1708018656-ship-it/-manbo-robot-dog/hardware/kicad/drc-report.txt

Manbo robot dog carrier board V2 rev 2.0 - generated board report (hardware/gen/drc.py, exact geometry)
board: 100 x 90 mm, 2 layers, 38 footprints
nets: 31, routed segments: 271 (1241 mm), vias: 13
clearance: signal 0.20 mm, power 0.30 mm, edge 0.50 mm
track widths: +3V3 0.4 mm, +5V 0.6 mm, +5V_SERVO 1.5 mm, GND 1 mm, VBAT 1.5 mm, VBAT_F 1.5 mm, VBAT_IN 1.5 mm, VBAT_RP 1.5 mm, signal 0.25 mm
unrouted connections: 0
clearance violations: 0
nets not fully connected: 0

Note: the GND pours on both layers are unfilled in the file; press B in
KiCad (Edit > Fill All Zones) before plotting. All GND pads are also
connected by tracks, so the board works without the pour.
