1708018656-ship-it/-manbo-robot-dog/hardware/lite/kicad/pinmap.md

# Manbo robot dog LITE board - Blue Pill pin map

Generated from `hardware/gen/design_lite.py`. Firmware: `make LITE=1` (or add `MANBO_LITE` in Keil). Voice module on USART3.

| Blue Pill pin | STM32 | Net | Goes to |
|---|---|---|---|
| 1 | PB12 | - |  |
| 2 | PB13 | - |  |
| 3 | PB14 | - |  |
| 4 | PB15 | - |  |
| 5 | PA8 | - |  |
| 6 | PA9 | - |  |
| 7 | PA10 | - |  |
| 8 | PA11 | - |  |
| 9 | PA12 | - |  |
| 10 | PA15 | - |  |
| 11 | PB3 | - |  |
| 12 | PB4 | - |  |
| 13 | PB5 | - |  |
| 14 | PB6 | - |  |
| 15 | PB7 | - |  |
| 16 | PB8 | OLED_SCL | J7.3 |
| 17 | PB9 | OLED_SDA | J7.4 |
| 18 | 5V | VLOGIC | (power) |
| 19 | GND | GND | (power) |
| 20 | 3V3 | +3V3 | (power) |
| 21 | GND | GND | (power) |
| 22 | GND | GND | (power) |
| 23 | 3V3 | +3V3 | (power) |
| 24 | NRST | - |  |
| 25 | PB11 | SU_TXD | J6.3 |
| 26 | PB10 | SU_RXD | J6.4 |
| 27 | PB1 | SERVO4_PWM | J5.3 |
| 28 | PB0 | SERVO3_PWM | J4.3 |
| 29 | PA7 | SERVO2_PWM | J3.3 |
| 30 | PA6 | SERVO1_PWM | J2.3 |
| 31 | PA5 | - |  |
| 32 | PA4 | - |  |
| 33 | PA3 | - |  |
| 34 | PA2 | - |  |
| 35 | PA1 | - |  |
| 36 | PA0 | - |  |
| 37 | PC15 | - |  |
| 38 | PC14 | - |  |
| 39 | PC13 | - |  |
| 40 | VBAT | - |  |
