1708018656-ship-it/-manbo-robot-dog/OPTIMIZATION_PLAN.md

# 曼波机器狗整体优化记录（2026-11-01 ～ 11-02，已全部完成）

基线：上游 `RussellCooper-DJZ/manbo-robot-dog` @ `9a3d315`，工作分支 `optimize-2026-11`。

## 状态

**全部完成（11/02）。** 原计划 11/01–11/04 四个时段，提前在 11/02 收尾。

| 检查 | 结果 |
|---|---|
| 主机单元测试（8 组） | 全部通过 |
| ARM GCC 构建（原版接线 / V2 底板） | 通过，0 警告；Flash 约 29.6 KB / 30.3 KB（共 64 KB） |
| Cortex-M3 语法检查、源码编码检查 | 通过 |
| 底板生成器自带 ERC / DRC | 0 违规、0 未连接 |
| **KiCad 8 官方 ERC** | 0 违规 |
| **KiCad 8 官方 DRC**（含原理图一致性） | 0 违规、0 未连接、0 一致性问题 |

以上均在 GitHub Actions 上每次推送自动运行。

## 基线审计结论（11/01）

- 主机单元测试：3 组全部通过（state machine 32 / boundary 100 / format contract）。
- 用 clang `--target=thumbv7m-none-eabi` 对 Keil 工程内全部 C 文件做语法检查（本环境装不了 arm-none-eabi-gcc，无法链接出 .hex）。
- 仓库**没有任何原理图 / PCB 文件**，硬件只有文档描述 → 11/03 从零设计。

### 当前固件引脚表（以代码为准，PCB 将按此设计）

| 功能 | 外设 | 引脚 |
|---|---|---|
| 舵机 ×4 | TIM3 CH1–CH4，50 Hz PWM | PA6, PA7, PB0, PB1 |
| 蓝牙 | USART1 | PA9 (TX), PA10 (RX) |
| SYN6288 语音合成 | USART2 | PA2 (TX), PA3 (RX) |
| ASR 语音识别 | USART3 | PB10 (TX), PB11 (RX) |
| 系统时基 | TIM4 1 ms 中断 | — |
| 板载 LED | GPIO | PC13 |
| OLED（软件 I2C） | GPIO | PB8 (SCL), PB9 (SDA) |
| HC-SR04 超声波 | GPIO + TIM2 计时 | PA0 (Trig), PA1 (Echo) |
| 红外 ×4 | GPIO 输入 | PA4, PA5, PA11, PA12 |

### 11/01 发现的硬件级问题（PCB 设计必须解决）

1. **HC-SR04 Echo 是 5 V 输出，直接接 PA1，而 PA0–PA7 不是 5 V 容忍引脚**，长期使用可能损坏 MCU。→ PCB 上加分压（如 1 kΩ/2 kΩ）或换 3.3 V 版本 RCWL-9610。
2. **红外用了 PA11/PA12 = USB D-/D+**。Blue Pill 板载 PA12 有 1.5 kΩ（常见误焊 10 kΩ）上拉到 3.3 V，会干扰红外读数。→ 新底板把 4 路红外移到 PB12–PB15（5 V 容忍、无冲突），固件同步改。
3. **没有电池电压检测**：所有 ADC 引脚都被占用。红外迁走后释放 PA4 → 电池分压采样，低电量自动趴下+语音提醒。
4. 舵机与逻辑共用电源时，4 个 SG90 同时起动的峰值电流（约 2–3 A）会把 3.3 V 拉低导致复位。→ 舵机电源独立 DC-DC + 大电容。

## 已完成

### 11/01
1. **修复：高级动作语音变成拼音字母朗读**（回归 bug）。非阻塞重构时把中文提示语换成了 `"wo ai ni"` 等拼音，SYN6288 会逐个念英文字母。改为 GBK 字节转义（源码保持 ASCII，任何编辑器打开都不会乱码）。
2. **修复：长语音被截断且可能截断半个汉字**。语音帧缓冲只有 50 字节（正文 ≤44 字节），`mode_biaobai()` 的 55 字节提示语会被砍掉尾部，还可能把一个 GBK 双字节汉字截成一半变成杂音。新增 `System/GbkText.h`，按 SYN6288 手册上限 200 字节并保证不拆汉字；阻塞驱动 `syn6288.c` 和非阻塞 `AudioTask.c` 共用。
3. **修复：`AudioTask` 中 `(uint8_t)strlen()` 溢出**，字符串超过 255 字节时长度会回绕。
4. **修复：`syn6288.c` 包含 `"delay.h"`**，实际文件是 `Delay.h`，在 Linux / CI（大小写敏感）上编译失败。
5. 新增主机测试 `tests/host/test_gbk_text.c`（13 项断言），并修正原测试中锁定拼音行为的断言。

### 11/01（续）
6. **修复：主循环命令分发顺序错误，非阻塞状态机被绕过**。`main.c` 先调 `ActionTask_HandleCommand()` 再读串口，于是新收到的运动命令在同一轮直接掉进旧的阻塞式 `mode_xxx()`（`Delay_ms` 步态），下一轮又被 ActionTask 再执行一次：等于每个动作跑两遍，PoseStep 重构对运动命令完全没生效，急停也要等阻塞动作结束。现在先读串口再分发，ActionTask 优先。
7. 保留原版体验：前进/后退/转弯/摇摆/跳舞会一直重复，直到收到新命令（重构后变成只走一步）。
8. 体力/开心值规则从旧 `mode_xxx()` 迁到 `User/PetStats.h`（数值与 Mode.c 一一对应），新增 20 项主机测试；每个命令对应的 OLED 表情保留。
9. 删除没进工程的死代码：`Hardware/Serial.c/.h`（里面有重复的 `USART1_IRQHandler`，一旦加进工程就链接失败）、空的 `Hardware/Mode.c/.h`（会遮蔽 `User/Mode.h`）。
10. 加 `.gitattributes` / `.editorconfig` 统一换行。
11. **ASRPro 协议对齐**：`CMD_STAND='1'`（STM32 上是抬头）改成 `'q'`，`CMD_SIT='3'`（STM32 不处理）改成 `'s'`，握手改成 `'j'`（交替抬手），补全全部命令常量。新增 `docs/protocol.md` 作为唯一权威协议表。
12. **ASRPro**：`delay(6000)` 阻塞改为 `millis()` 截止时间；非运动命令会取消待发送的停止命令；队列空指针保护；删除手工定义的 `__dso_handle`；`commands.h` 补 `<stdint.h>`（原来先包含它会编译失败）。
13. CI：GitHub Actions 每次推送跑主机测试 + `tools/check_firmware_syntax.sh`（clang 对 Keil 工程全部 27 个 C 文件做 Cortex-M3 语法检查，隐式函数声明直接报错）。
14. 换行符统一单独一个提交（`2b6f8bf`，无代码改动），后面的提交 diff 保持干净。
15. **修复：`Time` 在 `UltrasonicWave.c` 定义为普通变量，`Timer.c` 却声明为 `extern volatile`**：两个编译单元限定符不一致，超声波读数可能被编译器缓存。
16. **修复：体力/开心值在 OLED 上只显示 2 位**（体力 350 会显示成 "50"），统一 3 位。`move()` 加 `speed==0` 保护。
17. 新增 `User/BoardConfig.h`：默认保持原版引脚；定义 `MANBO_BOARD_V2` 后切到新 PCB 引脚（红外迁到 PB12–PB15，PA4 用于电池电压采样）。红外驱动改为用宏。

### 11/02
18. **修复：超声波避障基本测不到近处障碍物**。SensorTask 每 10 ms 才轮询一次 Echo 的上升/下降沿，170 cm 以内的回波（< 10 ms）大多整个错过，测到的也偏短。TIM2 中断本来就只在 Echo 为高时累加 100 µs 计数，现在等一个 30 ms 窗口直接读这个计数。新增主机测试按 0.1 ms 精度模拟中断：旧代码 100 cm / 10 cm 都测不到，新代码测 100 cm 得 101 cm、10 cm 触发右转。
19. **独立看门狗 IWDG**（约 1.6 s，调试暂停时冻结，`-DMANBO_NO_WATCHDOG` 可关）。看门狗复位后跳过开机问候，避免复位循环里一直叫。
20. 主循环里不可达的阻塞分发链删掉，换成只处理 n/K/T/Z 的 switch；新增测试保证协议里每个运动字节都由 ActionTask 接管。
21. **全部源码转 UTF-8**（`tools/fix_encoding.py`）：注释转 UTF-8，GBK 字符串改为 `\x` 转义 + 可读注释。逐个对比转换前后的目标文件，**二进制完全一致**。CI 加编码检查。
22. **电池电压检测**（新板 V2，PA4，100k/33k 分压）：8 点滑动平均，低电 6.8 V 语音提醒，6.4 V 趴下并拒绝动作，带 200 mV 回差；13 项测试。原版接线下自动变成空实现。
23. **舵机校准**：`ServoMath.h` 每个舵机可设 `SERVO_TRIM_DEG` 微调角度（装配后站不平时不用拆舵盘），可选软限位；整数运算，脉宽与原来完全一致；15 项测试。
24. **OLED 非阻塞刷新**：换表情不再同步刷整屏 1 KB，改为标记脏页，UI 任务每 10 ms 发一页。
26. **扩展底板 V2（提前完成）**：`hardware/gen/` 下的 Python 生成器是唯一数据源，输出 KiCad 8 原理图 + PCB、BOM、引脚表、SVG 预览，以及可直接下单的 Gerber/钻孔压缩包（`hardware/fab/`）。100×90 mm 双层，36 个网络全部自动布线（含 GND，22 个过孔），自带精确几何 DRC：0 间距违规、0 未连接；DRC 用故障注入验证过能抓出短路和断线。设计要点见 `hardware/README.md`。
28. **11/02 加时 30 分钟**：README 按现状重写，旧文档加"与当前代码不一致"提示，ASRPro 文档命令码同步。
29. **修复：连续两个命令会丢一个**。主循环原来读串口的"最后一个字节"变量，两个字节来得快（比如 App 连发 `x` 和 `f`）前一个就被覆盖。现在所有字节经环形缓冲进命令队列，蓝牙优先于语音；5 项新测试。
30. **修复：急停后又自己走起来**。安全任务处理急停后把标志清掉了，主循环看不到，持续行走马上恢复。现在标志保留到主循环取走为止。
31. 丝印引脚名缩成 3 个字符，排针上不再挤在一起。

32. **底板精简**：去掉电源指示灯 D1/R11（降压模块自带）、3.3 V 额外电容 C7（Blue Pill 自带）、4 个舵机信号串联电阻 R1–R4，共 7 个元件，电阻规格 7 种 → 5 种。保留开关/防反接（安全）和超声波分压（5 V、3.3 V 两种传感器都能用）。重新布线：31 个网络全通，过孔 22 → 13，DRC 0 违规。
33. 修复布线器的间距规则：信号线靠近电源铜时按两者中较大的间距（0.3 mm）避让，与 DRC 规则一致（之前是碰巧通过）。

34. **KiCad 8 实机校验**：CI 安装 KiCad 8，用 `kicad-cli` 跑 ERC、DRC（含原理图/PCB 一致性）并导出 Gerber 交叉核对。第一次运行发现 4 处元件禁布区（courtyard）重叠，生成器的检查改成与 KiCad 相同的规则后复现了这 4 处，调整布局后 KiCad 报告 0 问题。顺带修了自带 DRC 里一处圆形/矩形判断的潜在 bug。
35. GCC 构建补 `gcc/syscalls.c`，链接不再有 newlib 空实现警告；CI 的 checkout 升到 v5。

36. **精简版（LITE）**：按"只要语音口令 + 运动、尽量便宜"的需求新增。固件 `MANBO_LITE` 编译开关去掉屏幕、语音合成、超声波、红外和体力玩法，增加"10 秒没听到停就自己停"的保护，固件约 12 KB。新底板 70×54 mm、12 个元件：4 节 5 号电池 → SS34 防反接（顺便把新碱性电池的 6.4 V 压到舵机能承受的 6 V）→ 舵机；再经 M7 二极管 + 470 µF 给单片机和 SU-03T 单独供电，舵机启动不会复位。口令配置表见 `docs/su03t.md`。布线 10 个网络全通，0 违规。

37. **精简版加回屏幕和语音回复**：OLED 表情恢复（底板加 J7，从 Blue Pill 3.3 V 供电）；语音回复不用 SYN6288，改由 SU-03T 自带喇叭——识别后它自己回话，开机和自动停下时单片机通过串口发 `AA 55 <编号> 55 AA` 让它播报（`User/Voice.c`，完整版同一接口走 SYN6288）。USART3 增加非阻塞发送。精简版固件约 16.7 KB，底板 13 个网络全通、0 违规。

38. **嘉立创 EDA 导入报错修复**：用户把 PCB 导入嘉立创 EDA 后报 13 个"过孔尺寸"错误（孔 0.4 mm，默认规则要求 ≥0.5 mm）。过孔改为 0.5 mm 孔 / 1.0 mm 焊盘，信号线 0.25 → 0.254 mm（10 mil），丝印线宽 0.12 → 0.15 mm，全部落在嘉立创默认规则内；两块板重新布线，0 违规。顺带修正：自带 DRC 原来写死了旧过孔尺寸，现在直接用板上的实际值。

27. 复查时修正：保险丝从 1812（4 A 规格不存在、电压只有 6–8 V）改为 2920 3 A / ≥16 V。

25. 删除死代码：21 个不可达的 `mode_xxx()`、整个 `Movement.c`（步态已全部在 ActionTask 里）、超声波旧包装函数。代码段（不含 libc）从约 35 KB 降到约 22.5 KB。

## 没做 / 需要实物验证的

- **实物回归测试**：固件改动都有主机测试和真实 ARM 编译，但没在开发板上跑过；底板没打样。第一次上电请按 `hardware/README.md` 的步骤。
- **ASRPro 子项目在 CI 里编译**：它依赖 ASR PRO 厂商 SDK（`set_state_enter_wakeup` 等函数），仓库里没有，无法在 CI 链接；只做了语法检查。
- 可选：超声波改用 TIM2_CH2 硬件输入捕获（精度 1.7 cm → mm 级）。现在的精度对 15 cm 避障阈值已经足够。
