1708018656-ship-it/-manbo-robot-dog/docs/protocol.md

# 串口命令协议（唯一权威表）

蓝牙（USART1，PA9/PA10）和语音识别模块（USART3，PB10/PB11）都向 STM32 发送**单个 ASCII 字节**，9600 8N1。
STM32 端实现：`User/ActionTask.c` → `ActionTask_HandleCommand()`（动作），`User/main.c`（模式开关和状态播报）。
ASRPro 端常量：`ASRPro_Code/include/commands.h`，**改协议时两边和本表一起改**。

蓝牙优先于语音：同一轮里两个串口都收到数据时，以蓝牙为准。

## 运动（持续执行，直到收到新命令）

| 字节 | 动作 | 体力 | 开心 |
|---|---|---|---|
| `f` | 前进 | −5/步 | 连续第 6 步起 −3/步 |
| `b` | 后退 | −5/步 | 同上 |
| `l` | 左转 | −5/步 | 同上 |
| `r` | 右转 | −5/步 | 同上 |
| `w` | 前后摇摆 | −5 | +5 |
| `z` | 左右摇摆 | −5 | +5 |
| `d` | 跳舞 | −5 | +5 |

## 姿态 / 单次动作

| 字节 | 动作 | 体力 | 开心 |
|---|---|---|---|
| `5` | **急停 / 立正**（最高优先级，任何时候都会打断当前动作） | −1 | |
| `q` | 起身 | −1 | |
| `s` | 坐下擦脸 | +5 | +2 |
| `o` | 打招呼 | −2 | +2 |
| `j` | 交替抬手（语音"握手"映射到这里） | −5 | +2 |
| `y` | 伸懒腰 | +5 | +1 |
| `1` | 抬头 | −5 | |
| `p` | 趴下睡觉 | 恢复到 100 | +15 |
| `2` | 卧下睡觉 | 恢复到 100 | +15 |

## 语音表演

| 字节 | 内容 | 体力 | 开心 |
|---|---|---|---|
| `B` | 表白 | −2 | +5 |
| `Y` | 背元素周期表 | −2 | +2 |
| `X` | 背校训 | −2 | |
| `W` | 为世界之光 | | |
| `U` | 被叫"小呆" | | |
| `n` | 难受 | | |

## 模式开关与状态

| 字节 | 功能 |
|---|---|
| `x` / `c` | 打开 / 关闭超声波避障 |
| `H` / `h` | 打开 / 关闭红外防跌落 |
| `K` | 播报开心值 |
| `T` | 播报体力值 |
| `Z` | 播报开心值和体力值 |

## 规则

- 体力 ≤ 0 时只接受睡觉命令（`p` / `2`）。体力上限 500，开心上限 200。
- 数值规则在 `User/PetStats.h`，有主机单元测试 `tests/host/test_pet_stats.c`。
- 语音合成（USART2 → SYN6288）的文本必须是 **GBK** 编码，单帧最多 200 字节。源码里新增中文提示语请写成 `\x` 转义，参考 `User/ActionTask.c`。
