1708018656-ship-it/-manbo-robot-dog/hardware/采购清单.md

# 采购清单（整机）

板上元件的精确清单（位号、封装）见 [kicad/bom.csv](kicad/bom.csv)，由设计文件自动生成。下面是**整台机器狗**要买的东西，方便一次在淘宝 / 立创下单。数量都是一台的用量。

## 一、电路板和板上元件（V2 底板）

| 物品 | 数量 | 搜索关键词 | 说明 |
|---|---|---|---|
| PCB 打样 | 1（一般最少 5 片） | 嘉立创 / JLCPCB | 上传 `fab/manbo-carrier-gerbers.zip`，2 层、1.6 mm、100×90 mm |
| P-MOS 管 | 2 | AO4407A SOP-8 | Q1 开关、Q2 防反接 |
| 自恢复保险丝 | 1 | SMD2920P300TF 2920 3A | 耐压 ≥16 V |
| 0805 电阻 | 1k ×2、2k ×1、10k ×1、33k 1% ×1、100k 1% ×2 | 0805 电阻 | 建议直接买 0805 电阻样品本 |
| 0805 电容 100nF | 3 | 0805 104 | |
| 电解电容 | 1000µF 10V ×1、220µF 10V ×1、100µF 16V ×1 | 直插电解电容 | 1000µF 选 10×13 mm |
| XH2.54 2P 插座 + 端子线 | 2 套 | XH2.54 2P 直针 | 电池、开关各一 |
| 2.54 排针 | 1 条 40P | 2.54 单排针 | 舵机、模块座按需剪 |
| 2.54 单排母 1×20 | 2 | 2.54 单排母 20P | 插 Blue Pill |
| M3 铜柱 + 螺丝 | 4 套 | M3 尼龙/铜柱 | 固定底板 |

## 二、模块和整机零件

| 物品 | 数量 | 搜索关键词 | 说明 |
|---|---|---|---|
| Blue Pill 核心板 | 1 | STM32F103C8T6 最小系统板 | 尽量选正品芯片 |
| ST-Link V2 | 1 | ST-Link V2 下载器 | 烧录用，已有可不买 |
| 降压模块（舵机） | 1 | Mini560 5V 5A 或 MP1584 | **≥3 A**；可调的上板前先调到 5.0 V |
| 降压模块（逻辑） | 1 | MP1584 / Mini360 | ≥1 A，同样先调到 5.0 V |
| SG90 舵机 | 4（建议多买 1 个备用） | SG90 9g 舵机 | MG90S 金属齿更耐用，引脚兼容 |
| 0.96 寸 OLED | 1 | 0.96 OLED I2C 4 针 SSD1306 | 注意引脚顺序 GND-VCC-SCL-SDA |
| 蓝牙模块 | 1 | HC-05 或 HC-06 | |
| 语音合成 | 1 | SYN6288 模块 带喇叭 | |
| 语音识别 | 1 | ASR PRO 语音模块 | 可选 |
| 超声波 | 1 | HC-SR04（或 HC-SR04P 3.3V 版） | 两种都能用 |
| 红外避障模块 | 4 | FC-51 红外避障 | 用于防跌落 |
| 2S 锂电池 | 1 | 7.4V 2S 锂电池 XH 插头 | 容量 1000–2000 mAh 够用 |
| 2S 充电器 | 1 | 2S 平衡充 | |
| 小开关 | 1 | 船型/拨动开关 | 只走信号电流，任何小开关都行 |
| 杜邦线 | 若干 | 母对母杜邦线 | 接 SYN6288、ASR 等引脚顺序不固定的模块 |
| 机身结构 | 1 套 | 3D 打印 / 亚克力 | 原项目未提供结构文件 |
