1708018656-ship-it/-manbo-robot-dog/hardware/lite/采购清单.md

# 精简版采购清单

价格是淘宝常见价的大概范围，仅供参考，以实际下单为准。

| 物品 | 数量 | 搜索关键词 | 大概价格 | 说明 |
|---|---|---|---|---|
| Blue Pill 核心板 | 1 | STM32F103C8T6 最小系统板 | 10–15 元 | |
| SG90 舵机 | 4 | SG90 9g 舵机 | 16–24 元 | |
| SU-03T 离线语音模块（**带麦克风、喇叭**） | 1 | SU-03T 离线语音模块 带喇叭 | 8–15 元 | 语音识别 + 语音回复都靠它；可让店家按 [指令表](../../docs/su03t.md) 代烧录 |
| 0.96 寸 OLED（I2C，4 针） | 1 | 0.96 OLED I2C SSD1306 | 8–12 元 | 引脚顺序选 GND-VCC-SCL-SDA |
| 4 节 5 号电池盒（带开关、引线） | 1 | 4节5号电池盒 带开关 | 2–3 元 | 引线压 XH2.54 端子，或直接焊在板上 |
| SS34 二极管 | 1 | SS34 SMA | 几毛 | |
| M7（1N4007 贴片）二极管 | 1 | M7 SMA | 几毛 | |
| 1000µF 10V、470µF 10V 电解电容 | 各 1 | 直插电解电容 | 1 元左右 | |
| 0805 100nF 电容 | 1 | 0805 104 | 几毛 | |
| 2.54 排针、1×20 排母 ×2、XH2.54 2P | 若干 | | 2–3 元 | |
| PCB（或洞洞板） | 1 | 嘉立创打样 / 洞洞板 | 0–10 元 | 70×54 mm，打样一般最便宜那档 |
| USB 转 TTL（CH340） | 1 | CH340 USB转TTL | 约 5 元 | 烧 SU-03T 用；店家代烧可不买 |
| ST-Link V2 | 1 | ST-Link V2 | 15–20 元 | 烧 STM32 用，已有可不买 |
| 5 号电池 | 4 | 碱性或镍氢 | 自备 | |

**合计（不含电池、下载器）：大约 50–75 元**。语音回复由 SU-03T 自带喇叭完成，省掉约 50 元的 SYN6288；另外省在蓝牙、传感器和 2S 锂电供电。
