1708018656-ship-it/-manbo-robot-dog/hardware/kicad/manbo-carrier.kicad_pcb

## KiCad design hardware/kicad/manbo-carrier.kicad_pcb (2026-11-03)

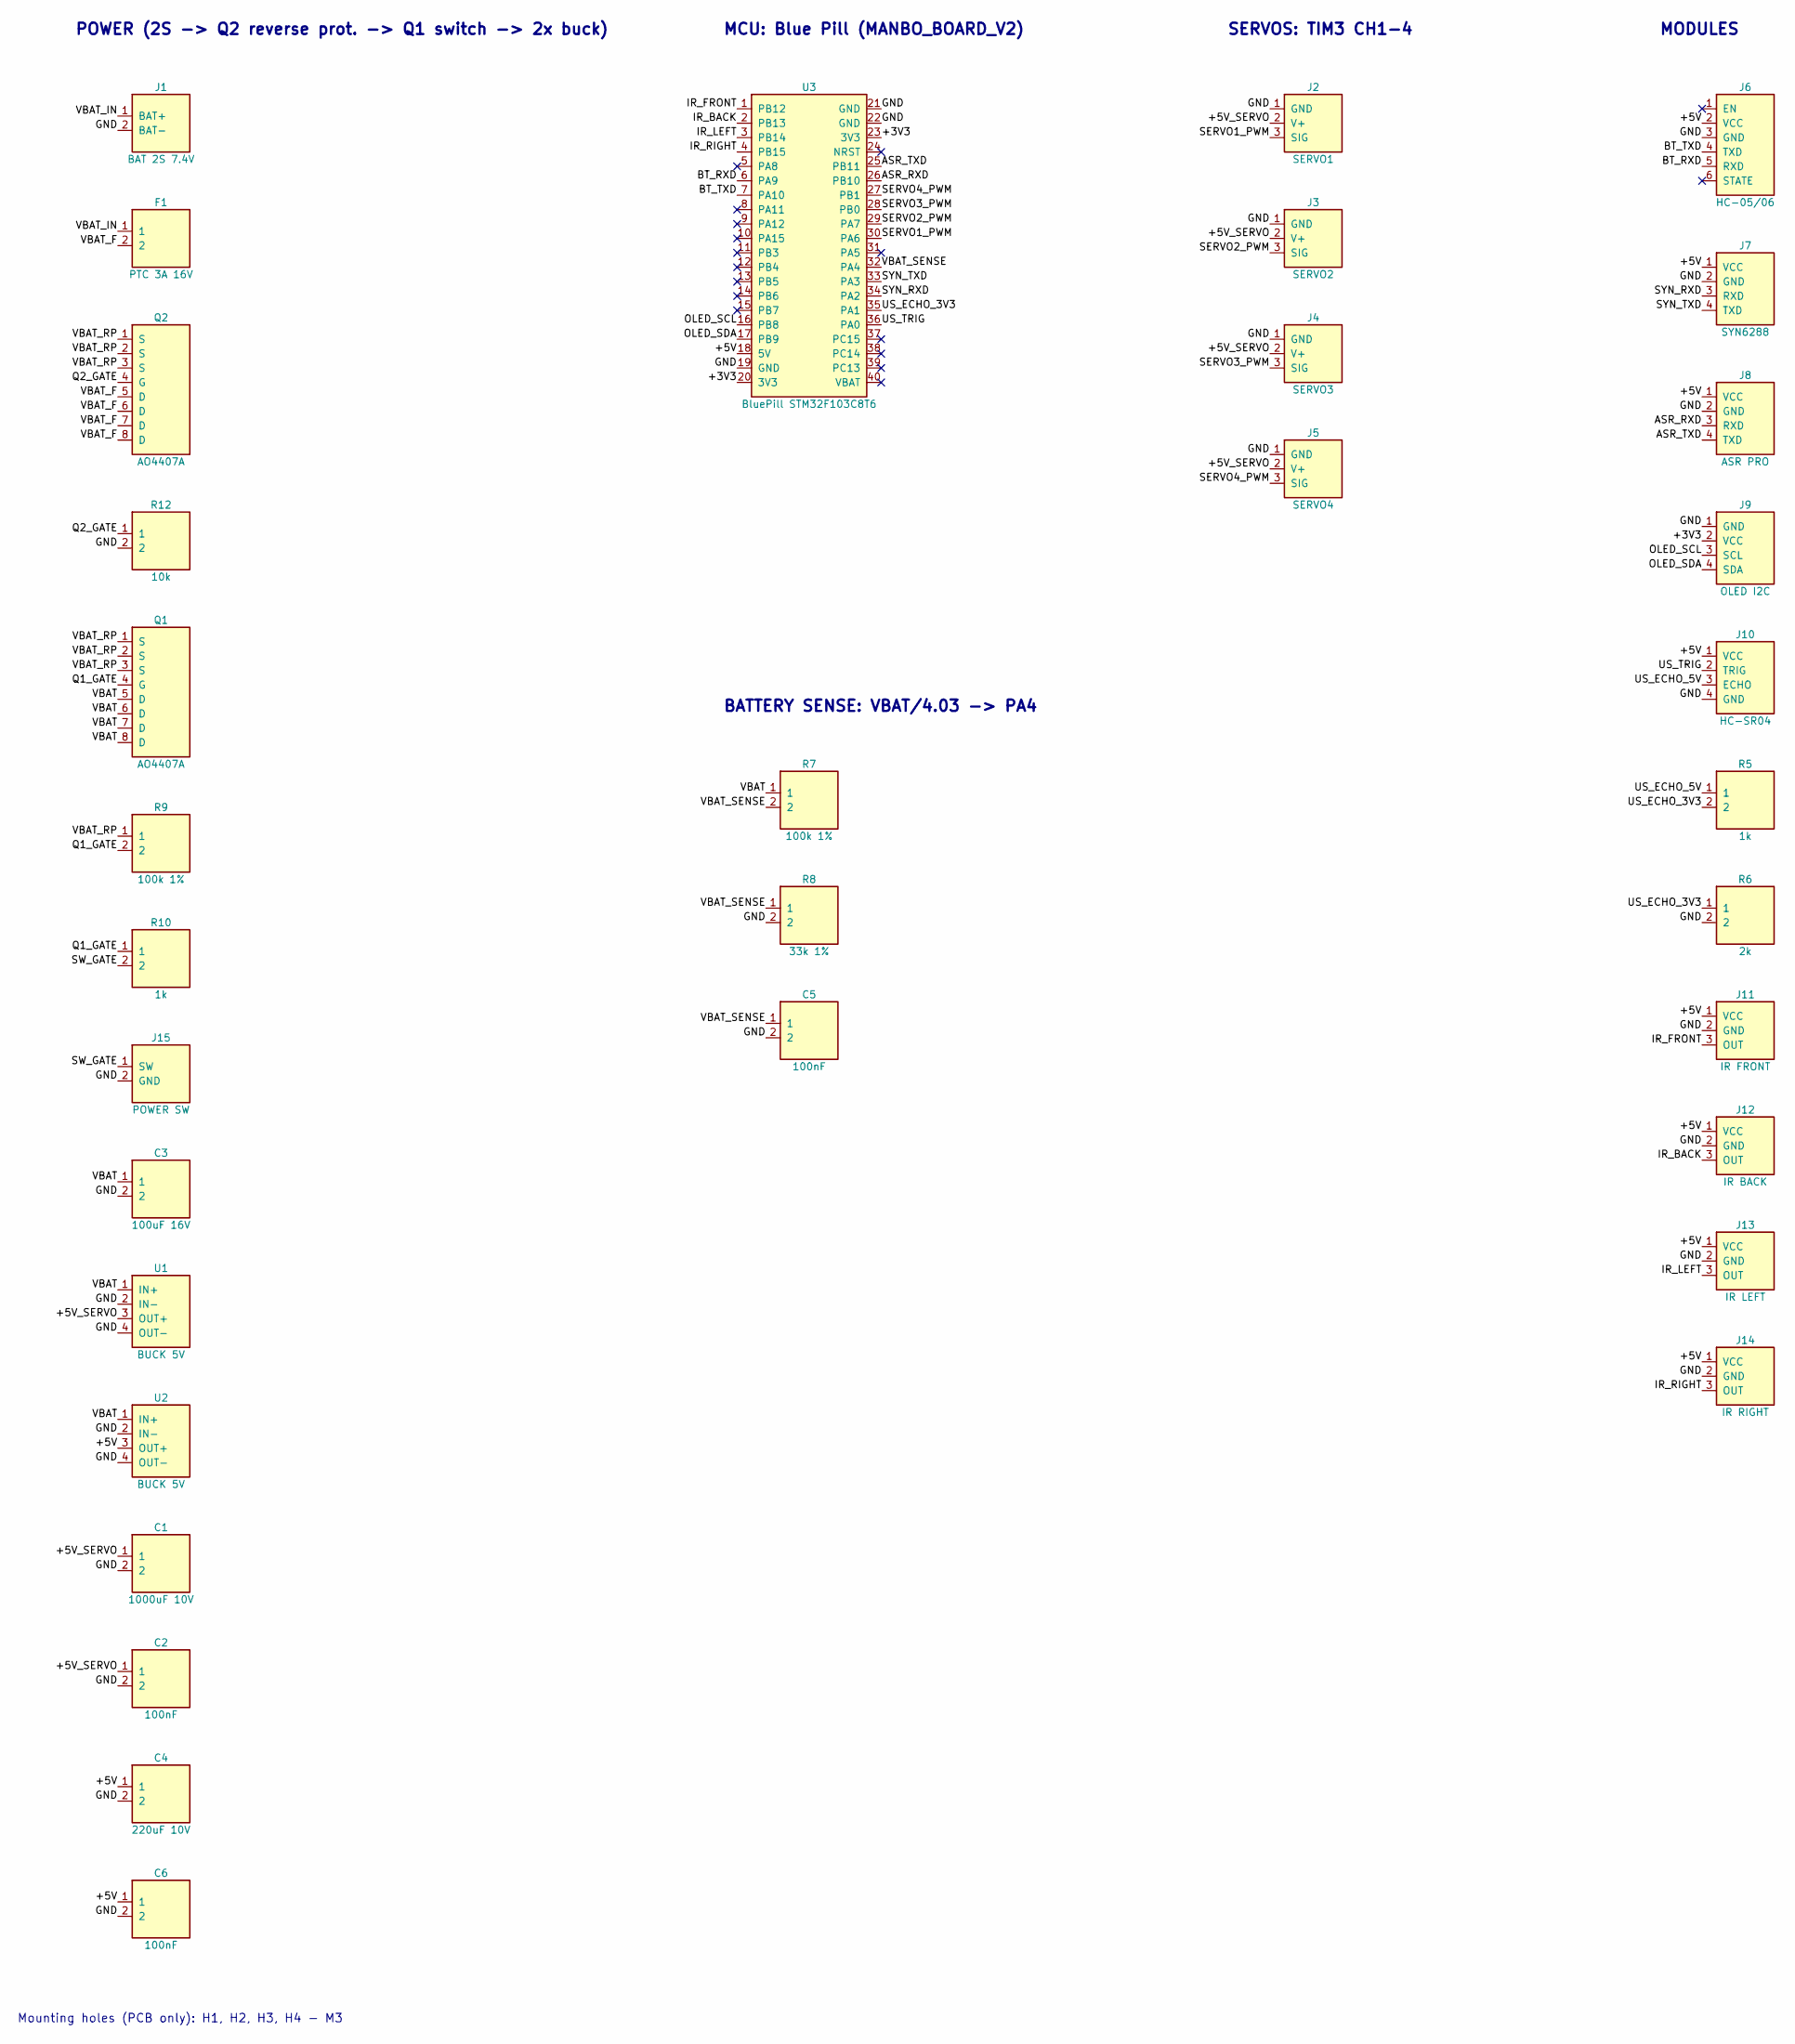
[picture p1: schematic manbo-carrier.kicad_sch, Manbo robot dog carrier board V2]

Parts:
C1: 1000uF 10V; CP_Radial_D10.0mm_P5.00mm; LCSC 1000uF 10V 10x13
C2, C5, C6: 100nF; C_0805_2012Metric; LCSC 0805 100nF
C3: 100uF 16V; CP_Radial_D6.3mm_P2.50mm; LCSC 100uF 16V 6.3x7
C4: 220uF 10V; CP_Radial_D6.3mm_P2.50mm; LCSC 220uF 10V 6.3x7
F1: PTC 3A 16V; Fuse_2920_7451Metric; LCSC SMD2920P300TF/24
J1: BAT 2S 7.4V; JST_XH_B2B-XH-A_1x02_P2.50mm_Vertical; LCSC XH2.54 2P
J2: SERVO1; PinHeader_1x03_P2.54mm_Vertical; LCSC 2.54mm header 3P
J3: SERVO2; PinHeader_1x03_P2.54mm_Vertical; LCSC 2.54mm header 3P
J4: SERVO3; PinHeader_1x03_P2.54mm_Vertical; LCSC 2.54mm header 3P
J5: SERVO4; PinHeader_1x03_P2.54mm_Vertical; LCSC 2.54mm header 3P
J6: HC-05/06; PinHeader_1x06_P2.54mm_Vertical; LCSC 2.54mm header 6P
J7: SYN6288; PinHeader_1x04_P2.54mm_Vertical; LCSC 2.54mm header 4P
J8: ASR PRO; PinHeader_1x04_P2.54mm_Vertical; LCSC 2.54mm header 4P
J9: OLED I2C; PinHeader_1x04_P2.54mm_Vertical; LCSC 2.54mm header 4P
J10: HC-SR04; PinHeader_1x04_P2.54mm_Vertical; LCSC 2.54mm header 4P
J11: IR FRONT; PinHeader_1x03_P2.54mm_Vertical; LCSC 2.54mm header 3P
J12: IR BACK; PinHeader_1x03_P2.54mm_Vertical; LCSC 2.54mm header 3P
J13: IR LEFT; PinHeader_1x03_P2.54mm_Vertical; LCSC 2.54mm header 3P
J14: IR RIGHT; PinHeader_1x03_P2.54mm_Vertical; LCSC 2.54mm header 3P
J15: POWER SW; JST_XH_B2B-XH-A_1x02_P2.50mm_Vertical; LCSC XH2.54 2P
Q1, Q2: AO4407A; SOIC-8_3.9x4.9mm_P1.27mm; LCSC AO4407A
R5, R10: 1k; R_0805_2012Metric; LCSC 0805 1k
R6: 2k; R_0805_2012Metric; LCSC 0805 2k
R7, R9: 100k 1%; R_0805_2012Metric; LCSC 0805 100k 1%
R8: 33k 1%; R_0805_2012Metric; LCSC 0805 33k 1%
R12: 10k; R_0805_2012Metric; LCSC 0805 10k
U1, U2: BUCK 5V; BuckModule_2x2_P2.54mm_17.78mm; LCSC MP1584 / Mini560 module
U3: BluePill STM32F103C8T6; BluePill_Socket_2x20_W15.24mm; LCSC Blue Pill STM32F103C8T6

Connections:
+3V3: J9.2 (VCC), U3.20 (3V3), U3.23 (3V3)
+5V: C4.1, C6.1, J6.2 (VCC), J7.1 (VCC), J8.1 (VCC), J10.1 (VCC), J11.1 (VCC), J12.1 (VCC), J13.1 (VCC), J14.1 (VCC), U2.3 (OUT+), U3.18 (5V)
+5V_SERVO: C1.1, C2.1, J2.2 (V+), J3.2 (V+), J4.2 (V+), J5.2 (V+), U1.3 (OUT+)
ASR_RXD: J8.3 (RXD), U3.26 (PB10)
ASR_TXD: J8.4 (TXD), U3.25 (PB11)
BT_RXD: J6.5 (RXD), U3.6 (PA9)
BT_TXD: J6.4 (TXD), U3.7 (PA10)
GND: C1.2, C2.2, C3.2, C4.2, C5.2, C6.2, J1.2 (BAT-), J2.1 (GND), J3.1 (GND), J4.1 (GND), J5.1 (GND), J6.3 (GND), J7.2 (GND), J8.2 (GND), J9.1 (GND), J10.4 (GND), J11.2 (GND), J12.2 (GND), J13.2 (GND), J14.2 (GND), J15.2 (GND), R6.2, R8.2, R12.2, U1.2 (IN-), U1.4 (OUT-), U2.2 (IN-), U2.4 (OUT-), U3.19 (GND), U3.21 (GND), U3.22 (GND)
IR_BACK: J12.3 (OUT), U3.2 (PB13)
IR_FRONT: J11.3 (OUT), U3.1 (PB12)
IR_LEFT: J13.3 (OUT), U3.3 (PB14)
IR_RIGHT: J14.3 (OUT), U3.4 (PB15)
OLED_SCL: J9.3 (SCL), U3.16 (PB8)
OLED_SDA: J9.4 (SDA), U3.17 (PB9)
Q1_GATE: Q1.4 (G), R9.2, R10.1
Q2_GATE: Q2.4 (G), R12.1
SERVO1_PWM: J2.3 (SIG), U3.30 (PA6)
SERVO2_PWM: J3.3 (SIG), U3.29 (PA7)
SERVO3_PWM: J4.3 (SIG), U3.28 (PB0)
SERVO4_PWM: J5.3 (SIG), U3.27 (PB1)
SW_GATE: J15.1 (SW), R10.2
SYN_RXD: J7.3 (RXD), U3.34 (PA2)
SYN_TXD: J7.4 (TXD), U3.33 (PA3)
US_ECHO_3V3: R5.2, R6.1, U3.35 (PA1)
US_ECHO_5V: J10.3 (ECHO), R5.1
US_TRIG: J10.2 (TRIG), U3.36 (PA0)
VBAT: C3.1, Q1.5 (D), Q1.6 (D), Q1.7 (D), Q1.8 (D), R7.1, U1.1 (IN+), U2.1 (IN+)
VBAT_F: F1.2, Q2.5 (D), Q2.6 (D), Q2.7 (D), Q2.8 (D)
VBAT_IN: F1.1, J1.1 (BAT+)
VBAT_RP: Q1.1 (S), Q1.2 (S), Q1.3 (S), Q2.1 (S), Q2.2 (S), Q2.3 (S), R9.1
VBAT_SENSE: C5.1, R7.2, R8.1, U3.32 (PA4)

Notes on the sheet:
POWER (2S -> Q2 reverse prot. -> Q1 switch -> 2x buck)
MCU: Blue Pill (MANBO_BOARD_V2)
SERVOS: TIM3 CH1-4
MODULES
BATTERY SENSE: VBAT/4.03 -> PA4
Mounting holes (PCB only): H1, H2, H3, H4 - M3

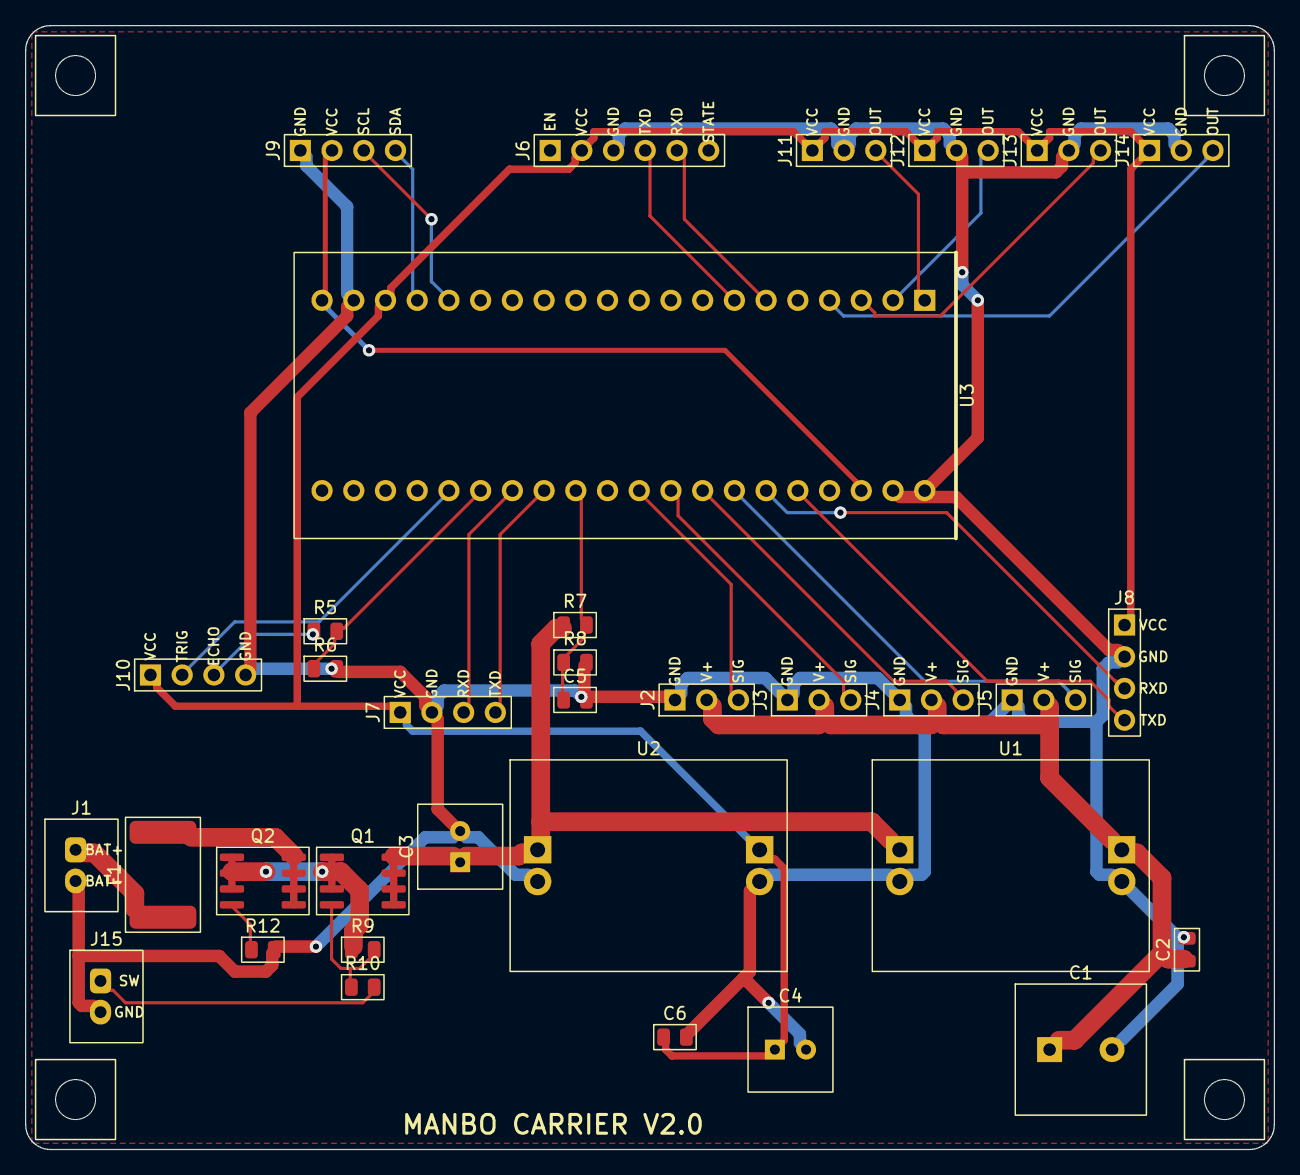
[picture p2: board manbo-carrier.kicad_pcb from above]

Board: 2 copper layers, 100.0 x 90.0 mm, 38 parts (0 on the bottom side), 31 nets.

Other parts of the board:
H1, H2, H3, H4: M3; MountingHole_3.2mm_M3
