1708018656-ship-it/-manbo-robot-dog/hardware/lite/kicad/manbo-lite.kicad_pcb

## KiCad design hardware/lite/kicad/manbo-lite.kicad_pcb (2026-11-03)

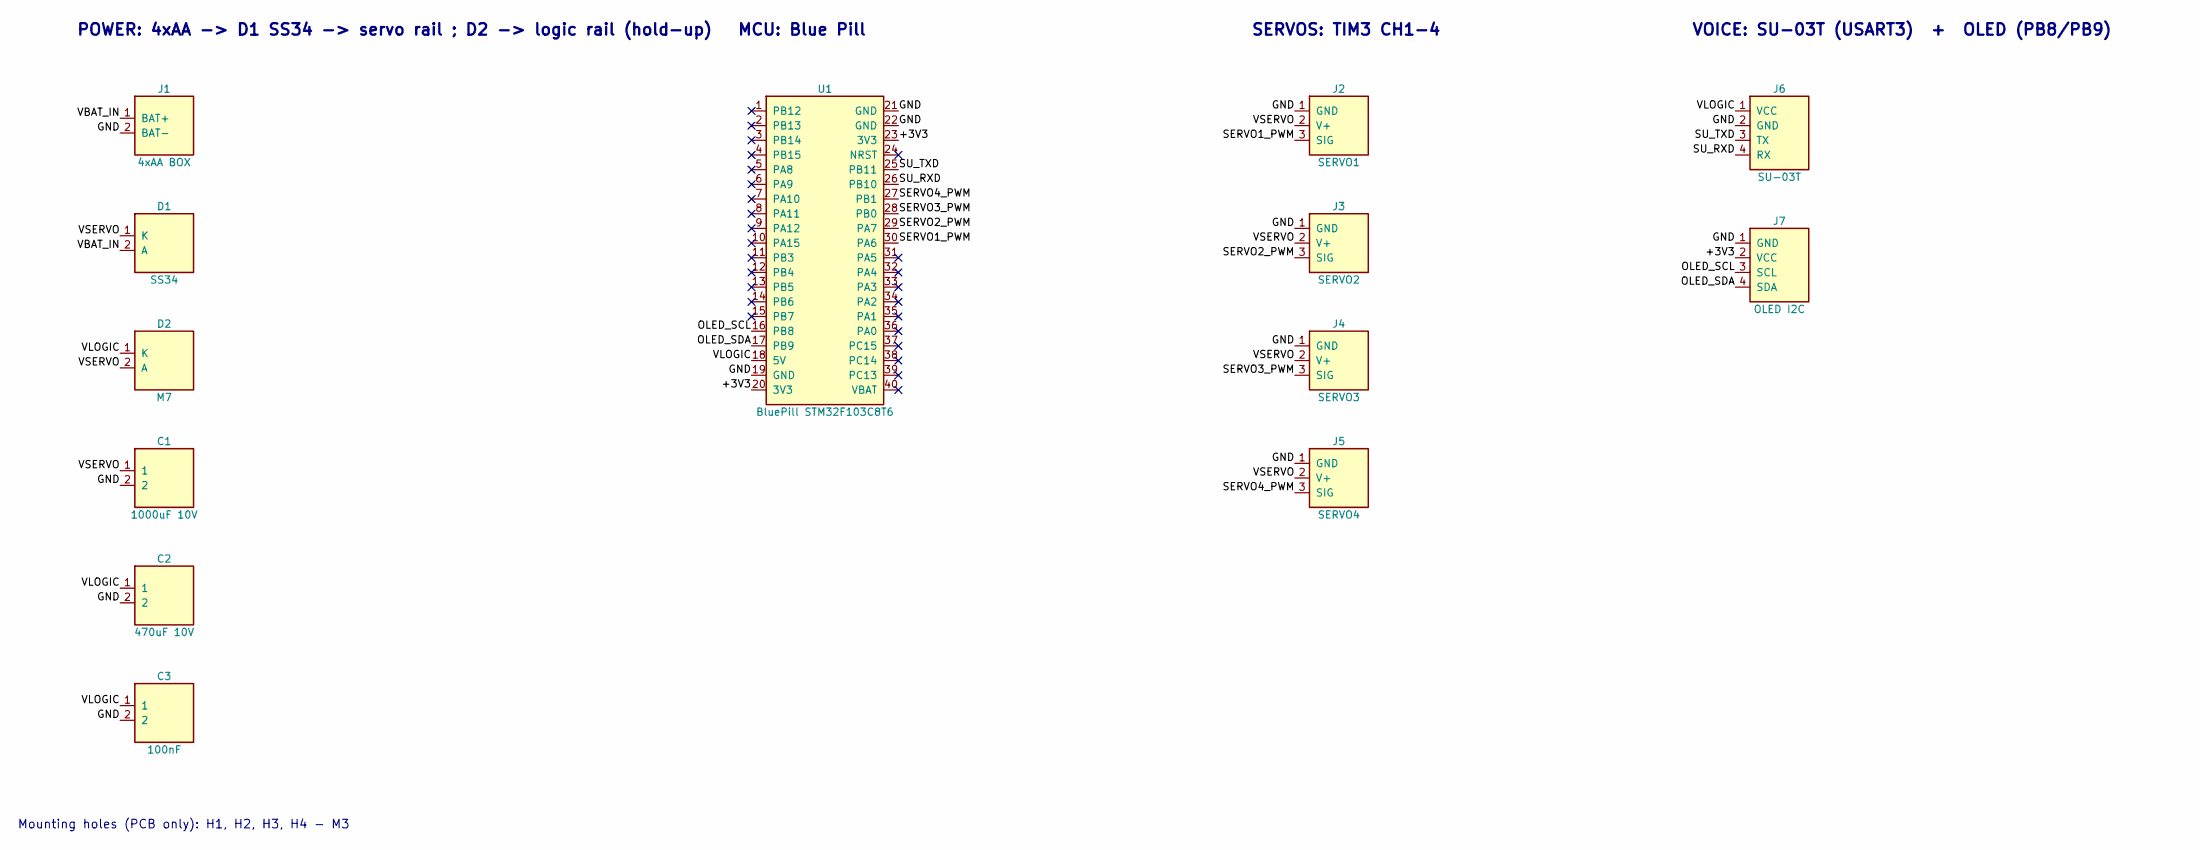
[picture p3: schematic manbo-lite.kicad_sch, Manbo robot dog LITE board]

Parts:
C1: 1000uF 10V; CP_Radial_D10.0mm_P5.00mm; LCSC 1000uF 10V 10x13
C2: 470uF 10V; CP_Radial_D8.0mm_P3.50mm; LCSC 470uF 10V 8x12
C3: 100nF; C_0805_2012Metric; LCSC 0805 100nF
D1: SS34; D_SMA; LCSC SS34 SMA
D2: M7; D_SMA; LCSC M7 1N4007 SMA
J1: 4xAA BOX; JST_XH_B2B-XH-A_1x02_P2.50mm_Vertical; LCSC XH2.54 2P
J2: SERVO1; PinHeader_1x03_P2.54mm_Vertical; LCSC 2.54mm header 3P
J3: SERVO2; PinHeader_1x03_P2.54mm_Vertical; LCSC 2.54mm header 3P
J4: SERVO3; PinHeader_1x03_P2.54mm_Vertical; LCSC 2.54mm header 3P
J5: SERVO4; PinHeader_1x03_P2.54mm_Vertical; LCSC 2.54mm header 3P
J6: SU-03T; PinHeader_1x04_P2.54mm_Vertical; LCSC 2.54mm header 4P
J7: OLED I2C; PinHeader_1x04_P2.54mm_Vertical; LCSC 2.54mm header 4P
U1: BluePill STM32F103C8T6; BluePill_Socket_2x20_W15.24mm; LCSC Blue Pill STM32F103C8T6

Connections:
+3V3: J7.2 (VCC), U1.20 (3V3), U1.23 (3V3)
GND: C1.2, C2.2, C3.2, J1.2 (BAT-), J2.1 (GND), J3.1 (GND), J4.1 (GND), J5.1 (GND), J6.2 (GND), J7.1 (GND), U1.19 (GND), U1.21 (GND), U1.22 (GND)
OLED_SCL: J7.3 (SCL), U1.16 (PB8)
OLED_SDA: J7.4 (SDA), U1.17 (PB9)
SERVO1_PWM: J2.3 (SIG), U1.30 (PA6)
SERVO2_PWM: J3.3 (SIG), U1.29 (PA7)
SERVO3_PWM: J4.3 (SIG), U1.28 (PB0)
SERVO4_PWM: J5.3 (SIG), U1.27 (PB1)
SU_RXD: J6.4 (RX), U1.26 (PB10)
SU_TXD: J6.3 (TX), U1.25 (PB11)
VBAT_IN: D1.2 (A), J1.1 (BAT+)
VLOGIC: C2.1, C3.1, D2.1 (K), J6.1 (VCC), U1.18 (5V)
VSERVO: C1.1, D1.1 (K), D2.2 (A), J2.2 (V+), J3.2 (V+), J4.2 (V+), J5.2 (V+)

Notes on the sheet:
POWER: 4xAA -> D1 SS34 -> servo rail ; D2 -> logic rail (hold-up)
MCU: Blue Pill
SERVOS: TIM3 CH1-4
VOICE: SU-03T (USART3) + OLED (PB8/PB9)
Mounting holes (PCB only): H1, H2, H3, H4 - M3

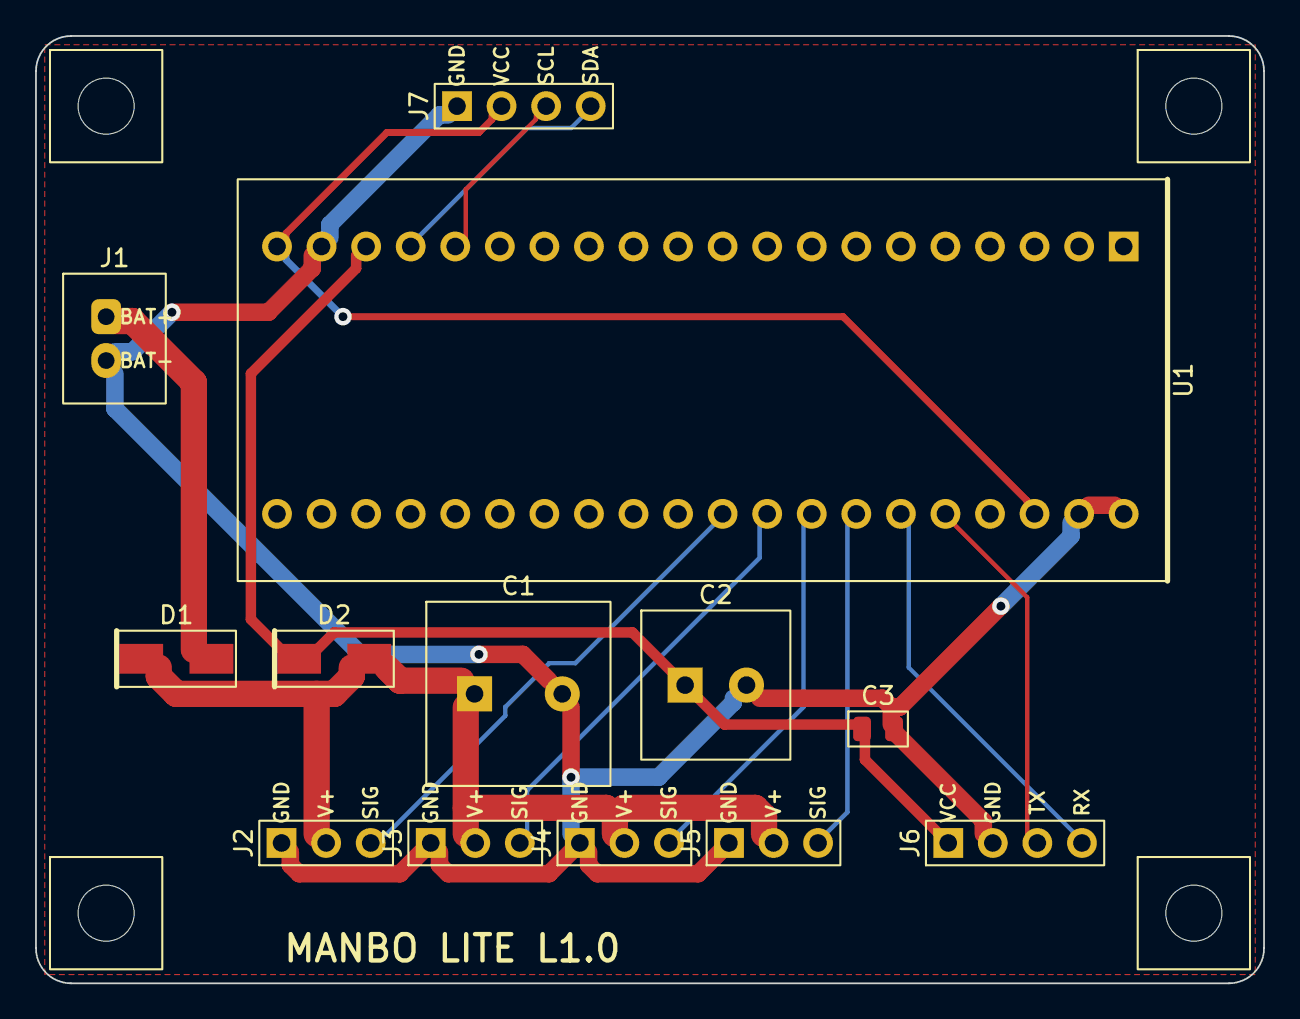
[picture p4: board manbo-lite.kicad_pcb from above]

Board: 2 copper layers, 70.0 x 54.0 mm, 17 parts (0 on the bottom side), 13 nets.

Other parts of the board:
H1, H2, H3, H4: M3; MountingHole_3.2mm_M3
