1708018656-ship-it/-manbo-robot-dog/hardware/gen/design_lite.py

"""
Manbo LITE board - the cheapest build that listens, walks, talks back and shows faces.

Only what is needed for "voice command -> motion":
  4xAA battery box (with its own switch) -> SS34 (reverse protection, also
  trims fresh alkaline 6.4 V to ~6 V for the servos) -> servo rail with a
  1000 uF reservoir; a second diode feeds the logic rail with a 470 uF
  hold-up cap so servo current dips cannot reset the MCU.
  Blue Pill + 4 servo headers + SU-03T offline voice module (UART, speaks
  replies through its own speaker) + 0.96in I2C OLED.

Generated by:  python3 hardware/gen/build.py --variant lite
Firmware:      make LITE=1   (MANBO_LITE; USART3 = SU-03T, 9600 8N1)
"""

from design import Part, two_pin, header, BLUEPILL_LEFT, BLUEPILL_RIGHT, R0805, C0805  # noqa: F401

TITLE = "Manbo robot dog LITE board"
REV = "L1.0"
MCU_REF = "U1"
FIRMWARE_NOTE = "Firmware: `make LITE=1` (or add `MANBO_LITE` in Keil). Voice module on USART3."
SHEET_TITLES = {"power": "POWER: 4xAA -> D1 SS34 -> servo rail ; D2 -> logic rail (hold-up)",
                "mcu": "MCU: Blue Pill", "servo": "SERVOS: TIM3 CH1-4",
                "modules": "VOICE: SU-03T (USART3)  +  OLED (PB8/PB9)"}

PARTS = []
P = PARTS.append

P(Part("J1", "4xAA BOX", "Connector_JST:JST_XH_B2B-XH-A_1x02_P2.50mm_Vertical",
       [("1", "BAT+"), ("2", "BAT-")], {"1": "VBAT_IN", "2": "GND"},
       "4xAA battery box with switch (NiMH 4.8 V or alkaline 6 V)", "XH2.54 2P", group="power"))
# KiCad D_SMA: pad 1 = cathode
P(Part("D1", "SS34", "Diode_SMD:D_SMA", [("1", "K"), ("2", "A")], {"1": "VSERVO", "2": "VBAT_IN"},
       "Schottky 3 A: reverse-polarity protection for the whole board", "SS34 SMA", group="power"))
P(Part("D2", "M7", "Diode_SMD:D_SMA", [("1", "K"), ("2", "A")], {"1": "VLOGIC", "2": "VSERVO"},
       "1N4007 (M7): logic rail isolation, drops ~0.8 V so fresh alkaline stays below 5.5 V",
       "M7 1N4007 SMA", group="power"))
P(two_pin("C1", "1000uF 10V", "Capacitor_THT:CP_Radial_D10.0mm_P5.00mm", "VSERVO", "GND",
          "Servo rail reservoir", "1000uF 10V 10x13", "power"))
P(two_pin("C2", "470uF 10V", "Capacitor_THT:CP_Radial_D8.0mm_P3.50mm", "VLOGIC", "GND",
          "Logic hold-up: keeps MCU + voice module alive through servo dips", "470uF 10V 8x12", "power"))
P(two_pin("C3", "100nF", C0805, "VLOGIC", "GND", "Voice module decoupling", "0805 100nF", "power"))

BP_NETS = {"PA6": "SERVO1_PWM", "PA7": "SERVO2_PWM", "PB0": "SERVO3_PWM", "PB1": "SERVO4_PWM",
           "PB10": "SU_RXD", "PB11": "SU_TXD", "5V": "VLOGIC", "GND": "GND",
           "PB8": "OLED_SCL", "PB9": "OLED_SDA", "3V3": "+3V3"}
bp_pins, bp_nets = [], {}
for i, name in enumerate(BLUEPILL_LEFT + BLUEPILL_RIGHT):
    bp_pins.append((str(i + 1), name))
    if name in BP_NETS:
        bp_nets[str(i + 1)] = BP_NETS[name]
P(Part("U1", "BluePill STM32F103C8T6", "manbo:BluePill_Socket_2x20_W15.24mm", bp_pins, bp_nets,
       "Blue Pill on 2x 1x20 female headers", "Blue Pill STM32F103C8T6", group="mcu"))

for n in range(1, 5):
    P(header("J%d" % (n + 1), "SERVO%d" % n, ["GND", "V+", "SIG"], ["GND", "VSERVO", "SERVO%d_PWM" % n],
             "SG90 servo %d (brown=GND, red=V+, orange=SIG)" % n, group="servo"))

# SU-03T: B7 = UART1 TXD, B6 = UART1 RXD (module datasheet); 3.3 V IO, VCC 3.6-5.5 V
P(header("J6", "SU-03T", ["VCC", "GND", "TX", "RX"], ["VLOGIC", "GND", "SU_TXD", "SU_RXD"],
         "SU-03T voice module: VCC, GND, TX(B7), RX(B6); mic + speaker plug into the module",
         group="modules"))

P(header("J7", "OLED I2C", ["GND", "VCC", "SCL", "SDA"], ["GND", "+3V3", "OLED_SCL", "OLED_SDA"],
         "0.96in SSD1306 I2C OLED, powered from the Blue Pill 3V3 (plugs in directly)", group="modules"))

for i in range(1, 5):
    P(Part("H%d" % i, "M3", "MountingHole:MountingHole_3.2mm_M3", [], {}, "M3 mounting hole", group="mech"))

POWER_NETS = {"GND", "VBAT_IN", "VSERVO", "VLOGIC", "+3V3"}
NET_WIDTH = {"GND": 1.0, "VBAT_IN": 1.5, "VSERVO": 1.5, "VLOGIC": 0.6, "+3V3": 0.4}
DEFAULT_WIDTH = 0.254   # 10 mil: the usual JLC default rule
NETCLASS_PATTERNS = [{"netclass": "Battery", "pattern": "VBAT*"},
                     {"netclass": "Servo", "pattern": "VSERVO"},
                     {"netclass": "Logic5V", "pattern": "VLOGIC"},
                     {"netclass": "GND", "pattern": "GND"}]
FIRMWARE_PINS = {"PA6": "SERVO1_PWM", "PA7": "SERVO2_PWM", "PB0": "SERVO3_PWM", "PB1": "SERVO4_PWM",
                 "PB10": "SU_RXD", "PB11": "SU_TXD", "PB8": "OLED_SCL", "PB9": "OLED_SDA"}


def nets():
    out = {}
    for p in PARTS:
        for num, net in p.nets.items():
            out.setdefault(net, []).append((p.ref, num))
    return out
