1708018656-ship-it/-manbo-robot-dog/System/usart3.c

#include "stm32f10x.h"                  // Device header
#include <stdio.h>
#include <stdarg.h>
#include "Delay.h"
#include "ByteRing.h"
#include <stdlib.h>
//***语音识别***//

uint8_t USART3_RxData;		//定义串口接收的数据变量
uint8_t USART3_RxFlag;		//定义串口接收的标志位变量	
static ByteRing g_USART3_rx_ring;

/* Non-blocking transmit (used by the LITE build to trigger SU-03T phrases). */
#define USART3_TX_CAPACITY 64U
static volatile uint8_t USART3_TxBuffer[USART3_TX_CAPACITY];
static volatile uint8_t USART3_TxHead;
static volatile uint8_t USART3_TxTail;

/**
  * 函    数：串口初始化
  * 参    数：无
  * 返 回 值：无
  */
void USART3_Init(void)
{
	ByteRing_Init(&g_USART3_rx_ring);
	/*开启时钟*/
	RCC_APB1PeriphClockCmd(RCC_APB1Periph_USART3, ENABLE);	//开启USART3的时钟（语音识别）
	RCC_APB2PeriphClockCmd(RCC_APB2Periph_GPIOB, ENABLE);	//开启GPIOB的时钟
	/*GPIO初始化*/
	GPIO_InitTypeDef GPIO_InitStructure;
	GPIO_InitStructure.GPIO_Speed = GPIO_Speed_50MHz;
	GPIO_InitStructure.GPIO_Mode = GPIO_Mode_AF_PP;
	GPIO_InitStructure.GPIO_Pin = GPIO_Pin_10;
	GPIO_Init(GPIOB, &GPIO_InitStructure);					//将PB10引脚初始化为复用推挽输出,PB10是TX
	
	GPIO_InitStructure.GPIO_Mode = GPIO_Mode_IPU;
	GPIO_InitStructure.GPIO_Pin = GPIO_Pin_11;
	GPIO_Init(GPIOB, &GPIO_InitStructure);					//将PB11引脚初始化为输入,PB11是RX
	
	/*USART初始化*/
	USART_InitTypeDef USART_InitStructure;					//定义结构体变量
	USART_InitStructure.USART_BaudRate = 9600;				//波特率
	USART_InitStructure.USART_HardwareFlowControl = USART_HardwareFlowControl_None;	//硬件流控制，不需要
	USART_InitStructure.USART_Mode = USART_Mode_Tx | USART_Mode_Rx;	//模式，发送模式和接收模式均选择
	USART_InitStructure.USART_Parity = USART_Parity_No;		//奇偶校验，不需要
	USART_InitStructure.USART_StopBits = USART_StopBits_1;	//停止位，选择1位
	USART_InitStructure.USART_WordLength = USART_WordLength_8b;		//字长，选择8位
	USART_Init(USART3, &USART_InitStructure);				//将结构体变量交给USART_Init，配置USART3
	
	/*中断输出配置*/
	USART_ITConfig(USART3, USART_IT_RXNE, ENABLE);			//开启串口接收数据的中断
	/*NVIC中断分组*/
	NVIC_PriorityGroupConfig(NVIC_PriorityGroup_2);			//配置NVIC为分组2
	/*NVIC配置*/
	NVIC_InitTypeDef NVIC_InitStructure;					//定义结构体变量
	NVIC_InitStructure.NVIC_IRQChannel = USART3_IRQn;		//选择配置NVIC的USART1线
	NVIC_InitStructure.NVIC_IRQChannelCmd = ENABLE;			//指定NVIC线路使能
	NVIC_InitStructure.NVIC_IRQChannelPreemptionPriority = 1;		//指定NVIC线路的抢占优先级为
	NVIC_InitStructure.NVIC_IRQChannelSubPriority = 3;		//指定NVIC线路的响应优先级为
	NVIC_Init(&NVIC_InitStructure);							//将结构体变量交给NVIC_Init，配置NVIC外设
	
	/*USART使能*/
	USART_Cmd(USART3, ENABLE);								//使能USART3，串口开始运行
}


/**
  * 函    数：获取串口接收标志位
  * 参    数：无
  * 返 回 值：串口接收标志位，范围：0~1，接收到数据后，标志位置1，读取后标志位自动清零
  */
uint8_t USART3_ReadByte(uint8_t *value)
{
	return ByteRing_Pop(&g_USART3_rx_ring, value);
}

uint8_t USART3_RxOverflowed(void)
{
	return ByteRing_HasOverflowed(&g_USART3_rx_ring);
}

uint8_t USART3_GetRxFlag(void)
{
	if (USART3_RxFlag == 1)			//如果标志位为1
	{
		USART3_RxFlag = 0;
		return 1;					//则返回1，并自动清零标志位
	}
	return 0;						//如果标志位为0，则返回0
}

/**
  * 函    数：获取串口接收的数据
  * 参    数：无
  * 返 回 值：接收的数据，范围：0~255
  */
uint8_t USART3_GetRxData(void)
{
	return USART3_RxData;			//返回接收的数据变量
}

/**
  * 函    数：USART2中断函数
  * 参    数：无
  * 返 回 值：无
  * 注意事项：此函数为中断函数，无需调用，中断触发后自动执行
  *           函数名为预留的指定名称，可以从启动文件复制
  *           请确保函数名正确，不能有任何差异，否则中断函数将不能进入
  */

/* Queue up to len bytes; returns how many were accepted (never waits). */
uint8_t USART3_SendBytes(const uint8_t *data, uint8_t len)
{
	uint8_t accepted = 0U;
	uint8_t next_head;

	if (data == 0)
	{
		return 0U;
	}
	while (accepted < len)
	{
		next_head = (uint8_t)((USART3_TxHead + 1U) % USART3_TX_CAPACITY);
		if (next_head == USART3_TxTail)
		{
			break;
		}
		USART3_TxBuffer[USART3_TxHead] = data[accepted];
		USART3_TxHead = next_head;
		accepted++;
	}
	if (accepted != 0U)
	{
		USART_ITConfig(USART3, USART_IT_TXE, ENABLE);
	}
	return accepted;
}

uint8_t USART3_TxFree(void)
{
	return (uint8_t)((USART3_TxTail + USART3_TX_CAPACITY - USART3_TxHead - 1U) % USART3_TX_CAPACITY);
}

void USART3_IRQHandler(void)
{
	if (USART_GetITStatus(USART3, USART_IT_RXNE) == SET)		//判断是否是USART1的接收事件触发的中断
	{
		USART3_RxData = USART_ReceiveData(USART3);				//读取数据寄存器，存放在接收的数据变量
			ByteRing_PushFromIsr(&g_USART3_rx_ring, USART3_RxData);
		USART3_RxFlag = 1;										//置接收标志位变量为1
		USART_ClearITPendingBit(USART3, USART_IT_RXNE);			//清除USART1的RXNE标志位
																//读取数据寄存器会自动清除此标志位
																//如果已经读取了数据寄存器，也可以不执行此代码
	}

	if (USART_GetITStatus(USART3, USART_IT_TXE) == SET)
	{
		if (USART3_TxHead != USART3_TxTail)
		{
			USART_SendData(USART3, USART3_TxBuffer[USART3_TxTail]);
			USART3_TxTail = (uint8_t)((USART3_TxTail + 1U) % USART3_TX_CAPACITY);
		}
		else
		{
			USART_ITConfig(USART3, USART_IT_TXE, DISABLE);
		}
	}
}
