1708018656-ship-it/-manbo-robot-dog/System/usart2.c

#include "stm32f10x.h"                  // Device header
#include <stdio.h>
#include <stdarg.h>
#include "Delay.h"
#include <stdlib.h>
//***语音合成***//

uint8_t USART2_RxData;		//定义串口接收的数据变量
uint8_t USART2_RxFlag;

#define USART2_TX_CAPACITY 256U
static volatile uint8_t USART2_TxBuffer[USART2_TX_CAPACITY];
static volatile uint8_t USART2_TxHead;
static volatile uint8_t USART2_TxTail;
	//定义串口接收的标志位变量

/**
  * 函    数：串口初始化
  * 参    数：无
  * 返 回 值：无
  */
void USART2_Init(void)
{
	/*开启时钟*/
	RCC_APB2PeriphClockCmd(RCC_APB2Periph_GPIOA, ENABLE);	//开启GPIOA的时钟
	RCC_APB1PeriphClockCmd(RCC_APB1Periph_USART2, ENABLE);	//开启USART2的时钟（语音合成）
	/*GPIO初始化*/
	GPIO_InitTypeDef GPIO_InitStructure;
	GPIO_InitStructure.GPIO_Speed = GPIO_Speed_50MHz;
	GPIO_InitStructure.GPIO_Mode = GPIO_Mode_AF_PP;
	GPIO_InitStructure.GPIO_Pin = GPIO_Pin_2;
	GPIO_Init(GPIOA, &GPIO_InitStructure);					//将PA2引脚初始化为复用推挽输出,PA2是TX

	GPIO_InitStructure.GPIO_Mode = GPIO_Mode_IPU;
	GPIO_InitStructure.GPIO_Pin = GPIO_Pin_3;
	GPIO_Init(GPIOA, &GPIO_InitStructure);					//将PA3引脚初始化为输入,PA3是RX

	/*USART初始化*/
	USART_InitTypeDef USART_InitStructure;					//定义结构体变量
	USART_InitStructure.USART_BaudRate = 9600;				//波特率
	USART_InitStructure.USART_HardwareFlowControl = USART_HardwareFlowControl_None;	//硬件流控制，不需要
	USART_InitStructure.USART_Mode = USART_Mode_Tx | USART_Mode_Rx;	//模式，发送模式和接收模式均选择
	USART_InitStructure.USART_Parity = USART_Parity_No;		//奇偶校验，不需要
	USART_InitStructure.USART_StopBits = USART_StopBits_1;	//停止位，选择1位
	USART_InitStructure.USART_WordLength = USART_WordLength_8b;		//字长，选择8位
	USART_Init(USART2, &USART_InitStructure);				//将结构体变量交给USART_Init，配置USART2

	/*中断输出配置*/
	USART_ITConfig(USART2, USART_IT_RXNE, ENABLE);			//开启串口接收数据的中断
	/*NVIC中断分组*/
	NVIC_PriorityGroupConfig(NVIC_PriorityGroup_2);			//配置NVIC为分组2
	/*NVIC配置*/
	NVIC_InitTypeDef NVIC_InitStructure;					//定义结构体变量
	NVIC_InitStructure.NVIC_IRQChannel = USART2_IRQn;		//选择配置NVIC的USART1线
	NVIC_InitStructure.NVIC_IRQChannelCmd = ENABLE;			//指定NVIC线路使能
	NVIC_InitStructure.NVIC_IRQChannelPreemptionPriority = 1;		//指定NVIC线路的抢占优先级为
	NVIC_InitStructure.NVIC_IRQChannelSubPriority = 2;		//指定NVIC线路的响应优先级为
	NVIC_Init(&NVIC_InitStructure);							//将结构体变量交给NVIC_Init，配置NVIC外设

	/*USART使能*/
	USART_Cmd(USART2, ENABLE);								//使能USART2，串口开始运行
}


/**
  * 函    数：串口发送一个字符串
  * 参    数：String 要发送字符串的首地址,长度
  * 返 回 值：无
  */
uint8_t USART2_SendString(u8 *DAT, u8 len)
{
	u8 accepted = 0U;
	uint8_t next_head;

	if (DAT == 0)
	{
		return 0U;
	}

	while (accepted < len)
	{
		next_head = (uint8_t)(USART2_TxHead + 1U);
		if (next_head == USART2_TxTail)
		{
			break; /* bounded enqueue: never wait for TXE */
		}
		USART2_TxBuffer[USART2_TxHead] = DAT[accepted];
		USART2_TxHead = next_head;
		accepted++;
	}

	if (accepted != 0U)
	{
		USART_ITConfig(USART2, USART_IT_TXE, ENABLE);
	}
	return accepted;
}

/**
  * 函    数：获取串口接收标志位
  * 参    数：无
  * 返 回 值：串口接收标志位，范围：0~1，接收到数据后，标志位置1，读取后标志位自动清零
  */
uint8_t USART2_GetRxFlag(void)
{
	if (USART2_RxFlag == 1)			//如果标志位为1
	{
		USART2_RxFlag = 0;
		return 1;					//则返回1，并自动清零标志位
	}
	return 0;						//如果标志位为0，则返回0
}

/**
  * 函    数：获取串口接收的数据
  * 参    数：无
  * 返 回 值：接收的数据，范围：0~255
  */
uint8_t USART2_GetRxData(void)
{
	return USART2_RxData;			//返回接收的数据变量
}

/**
  * 函    数：USART2中断函数
  * 参    数：无
  * 返 回 值：无
  * 注意事项：此函数为中断函数，无需调用，中断触发后自动执行
  *           函数名为预留的指定名称，可以从启动文件复制
  *           请确保函数名正确，不能有任何差异，否则中断函数将不能进入
  */

void USART2_IRQHandler(void)
{
	if (USART_GetITStatus(USART2, USART_IT_RXNE) == SET)
	{
		USART2_RxData = USART_ReceiveData(USART2);
		USART2_RxFlag = 1;
		USART_ClearITPendingBit(USART2, USART_IT_RXNE);
	}

	if (USART_GetITStatus(USART2, USART_IT_TXE) == SET)
	{
		if (USART2_TxHead != USART2_TxTail)
		{
			USART_SendData(USART2, USART2_TxBuffer[USART2_TxTail]);
			USART2_TxTail++;
		}
		else
		{
			USART_ITConfig(USART2, USART_IT_TXE, DISABLE);
		}
	}
}
