1708018656-ship-it/-manbo-robot-dog/User/SafetyTask.c

#include "SafetyTask.h"
#include "ActionTask.h"

#define SAFETY_FAULT_COMM_OVERFLOW 0x01U

static volatile uint8_t g_stop_request = 0U;
static volatile uint8_t g_fault_flags = 0U;

void SafetyTask_Init(void)
{
    g_stop_request = 0U;
    g_fault_flags = 0U;
}

void SafetyTask_RequestEmergencyStop(void)
{
    g_stop_request = 1U;
}

void SafetyTask_RequestCommunicationFault(void)
{
    g_fault_flags |= SAFETY_FAULT_COMM_OVERFLOW;
    g_stop_request = 1U;
}

void SafetyTask_Run(uint32_t now_ms)
{
    (void)now_ms;

    if (g_stop_request != 0U)
    {
        /* Stop the motion now, but leave the request set: main() must also
         * see it (SafetyTask_ConsumeStopRequest) to cancel continuous walking,
         * otherwise the dog would start walking again right after the stop. */
        ActionTask_AbortToSafeStop();
    }
}

uint8_t SafetyTask_ConsumeStopRequest(void)
{
    uint8_t requested;

    requested = g_stop_request;
    g_stop_request = 0U;
    return requested;
}

uint8_t SafetyTask_IsFaultActive(void)
{
    return (g_fault_flags != 0U) ? 1U : 0U;
}
