1708018656-ship-it/-manbo-robot-dog/Hardware/UltrasonicWave.c

#include "stm32f10x.h"                  // Device header
/* HC-SR04 GPIO setup. Ranging itself is done by User/SensorTask.c. */

volatile uint16_t Time; /* written in TIM2 ISR; must match extern in Timer.c */ //记录时间
void UltrasonicWave_Init(void)
{
	RCC_APB2PeriphClockCmd(RCC_APB2Periph_GPIOA, ENABLE);	//开启GPIOA的时钟
	/*GPIO初始化*/ 
	GPIO_InitTypeDef GPIO_InitStructure;
	

	GPIO_InitStructure.GPIO_Mode = GPIO_Mode_Out_PP;
	GPIO_InitStructure.GPIO_Pin = GPIO_Pin_0;
	GPIO_InitStructure.GPIO_Speed = GPIO_Speed_50MHz;
	GPIO_Init(GPIOA, &GPIO_InitStructure);					//将PA0 TRIG
	
	GPIO_InitStructure.GPIO_Mode = GPIO_Mode_IPD;
	GPIO_InitStructure.GPIO_Pin = GPIO_Pin_1;
	GPIO_InitStructure.GPIO_Speed = GPIO_Speed_50MHz;
	GPIO_Init(GPIOA, &GPIO_InitStructure);					//将PA1 ECHO

	GPIO_ResetBits(GPIOA, GPIO_Pin_0);
	
	
}
