1708018656-ship-it/-manbo-robot-dog/User/Mode.h

#ifndef __MODE_H
#define __MODE_H
void mode_nanshou(void);//难受
void OLED_happiness(void);//OLED展示开心值
void mode_happiness(void);//展示开心值
void OLED_stamina(void);//OLED展示开心值
void mode_stamina(void);//展示体力值
void mode_index(void);//展示开心值和体力值
#endif
