1708018656-ship-it/-manbo-robot-dog/Hardware/Timer.c

#include "stm32f10x.h"                  // Device header
//为超声避障服务
extern volatile uint16_t Time;
void Timer_Init(void)
{
	Time = 0;
	RCC_APB1PeriphClockCmd(RCC_APB1Periph_TIM2, ENABLE);	//选择APB1总线下的定时器Timer2
	
	TIM_InternalClockConfig(TIM2);		//TIM2使用内部时钟
	
	TIM_TimeBaseInitTypeDef TIM_TimeBaseInitStructure;
	TIM_TimeBaseInitStructure.TIM_ClockDivision = TIM_CKD_DIV1;
	TIM_TimeBaseInitStructure.TIM_CounterMode = TIM_CounterMode_Up;		//计数模式，此处为向上计数
	TIM_TimeBaseInitStructure.TIM_Period = 7200-1;		//ARR 1 = 0.0001S
	TIM_TimeBaseInitStructure.TIM_Prescaler = 0;		//PSC
	TIM_TimeBaseInitStructure.TIM_RepetitionCounter = 0;		//高级计时器特有，重复计数
	TIM_TimeBaseInit(TIM2, &TIM_TimeBaseInitStructure);
	
	TIM_ClearFlag(TIM2, TIM_FLAG_Update);
	TIM_ITConfig(TIM2, TIM_IT_Update, ENABLE);		//使能中断
	
	NVIC_PriorityGroupConfig(NVIC_PriorityGroup_2);
	
	NVIC_InitTypeDef NVIC_InitStructure;
	NVIC_InitStructure.NVIC_IRQChannel = TIM2_IRQn;		//中断通道选择
	NVIC_InitStructure.NVIC_IRQChannelCmd = ENABLE;
	NVIC_InitStructure.NVIC_IRQChannelPreemptionPriority = 2;
	NVIC_InitStructure.NVIC_IRQChannelSubPriority = 1;		//优先级，同上
	
	NVIC_Init(&NVIC_InitStructure);
	
		TIM_Cmd(TIM2, ENABLE);		//打开定时器

}

void Timer_Stop(void)
{
	TIM_Cmd(TIM2, DISABLE);
	TIM_ITConfig(TIM2, TIM_IT_Update, DISABLE);
}

void TIM2_IRQHandler()		//定时器2的中断函数，不懂直接套用
{
	if(TIM_GetITStatus(TIM2, TIM_IT_Update) == SET)
	{

		if (GPIO_ReadInputDataBit(GPIOA, GPIO_Pin_1) == 1)
		{
			Time ++;
		}
		TIM_ClearITPendingBit(TIM2, TIM_IT_Update);		//清空标志位
	}
}
