1708018656-ship-it/-manbo-robot-dog/(commit log)

2026-08-14 优化舵机边界保护和串口指令判断
2026-08-14 修复三个高优先级内存与入口问题
2026-08-14 完善项目 README 文档
2026-08-14 新增非阻塞状态机重构方案
2026-08-14 实现协作式任务调度骨架
2026-08-14 接入通信任务与安全急停
2026-08-14 迁移基础动作到 PoseStep 状态机
2026-08-14 迁移复杂表演动作到 PoseStep
2026-08-14 迁移高级模式与非阻塞语音
2026-08-15 增加状态机主机单元测试
2026-08-15 增加串口和定时器边界测试
2026-08-15 修复格式化函数栈溢出风险
2026-08-15 refactor: complete non-blocking sensor and audio tasks
2026-08-19 Add on-target scheduler performance probes
2026-08-19 Gate performance probes out of production builds
2026-11-01 fix(audio): restore Chinese speech, GBK-safe 200-byte SYN6288 frames
    - Advanced actions spoke pinyin letters ("wo ai ni") after the
    non-blocking refactor; use GBK byte escapes so SYN6288 speaks Chinese
    and the source stays ASCII-clean.
    - Raise speech frame capacity from 44 to the SYN6288 limit of 200 bytes
    and never split a double-byte GBK character when truncating
    (new System/GbkText.h shared by syn6288.c and AudioTask.c).
    - Fix uint8_t overflow of strlen() in AudioTask.
    - Fix "delay.h" include case so the driver builds on case-sensitive FS.
    - Add host tests for GBK truncation; add OPTIMIZATION_PLAN.md.
    Claude-Session: https:/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
    [ActionTask.c, AudioTask.c, GbkText.h, syn6288.c, test_gbk_text.c, test_state_machine.c]
2026-11-01 docs(plan): record pin map and hardware-level issues for PCB redesign
    Claude-Session: https://claude.ai/code/session_011zCL3ZwaaXuHdfsgiLwp1L
2026-11-01 fix(main): route new commands to non-blocking ActionTask first
    The serial byte was read *after* ActionTask_HandleCommand(), so every new
    motion command fell into the blocking legacy mode_xxx() chain in the same
    loop iteration (Delay_ms-based gait), and was then executed a second time
    by ActionTask on the next iteration. The PoseStep refactor was effectively
    bypassed for motion commands.
    - Read USART1/USART3 before dispatch; ActionTask gets first refusal.
    - Keep legacy UX: walking/swing/dance repeat until a new command.
    - Move stamina/happiness rules into header-only User/PetStats.h
    (values copied 1:1 from Mode.c) with host tests, and keep the
    per-command OLED faces.
    - Remove dead files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
    [Mode.c, PetStats.h, main.c, test_pet_stats.c]
2026-11-01 fix(asr): align command codes with STM32, non-blocking stop
    - CMD_STAND '1'->'q', CMD_SIT '3'->'s', shake hand -> 'j'; add all
    remaining command constants. '1' is head-up on STM32 and '3' was
    never handled.
    - Replace delay(6000) with a millis() deadline serviced in ASR_Process();
    non-motion commands cancel a pending stop.
    - Guard queue use before ASR_Init(); drop hand-defined __dso_handle.
    - commands.h now includes <stdint.h> (failed when included first).
    - docs/protocol.md: single authoritative command table.
    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
    [asr.cpp, commands.h]
2026-11-01 fix: volatile mismatch on Time, 3-digit stat display, speed guard
    - UltrasonicWave.c defined `uint16_t Time` while Timer.c declared it
    `extern volatile`; the ISR-written counter could be cached. Define it
    volatile.
    - Stamina goes up to 500 and happiness to 200, but OLED_ShowNum used
    2 digits unless the value was exactly 100 (350 displayed as "50").
    - move(): guard speed==0 before 1000/speed.
    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
    [Mode.c, UltrasonicWave.c]
2026-11-01 feat(board): BoardConfig.h with MANBO_BOARD_V2 pin map
    Default keeps the original wiring. MANBO_BOARD_V2 (new carrier PCB)
    moves the four IR sensors from PA4/PA5/PA11/PA12 to 5V-tolerant
    PB12..PB15 (PA11/PA12 are USB D-/D+ and Blue Pill pulls PA12 up),
    freeing PA4 for battery-voltage sensing.
    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
2026-11-01 fix(ir): non-blocking cliff avoidance through ActionTask
    Edge_detect() ran blocking move_behind()/move_forward() sequences, so
    emergency stop and all tasks froze while avoiding a cliff. It now submits
    a pre-emptive avoidance action to ActionTask and returns 1 so main()
    cancels continuous walking (no walking back into the edge).
    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
    [Hongwai.c, Hongwai.h, main.c]
2026-11-01 build: GCC Makefile, linker script and C startup; CI ARM build
    - Makefile reuses the C file list from Project.uvprojx; Keil startup .s
    is ARMCC-only so gcc/startup_stm32f103xb.c provides the same vector
    table. `make V2=1` selects the new carrier PCB pin map.
    - gcc/STM32F103C8Tx.ld: 64K flash / 20K RAM, stack/heap as in Keil.
    - Fix old CMSIS core_cm3.c strex{,b,h} asm constraints ("=&r"); modern
    GCC rejects them with "registers may not be the same".
    - CI: build both board variants with arm-none-eabi-gcc, upload .hex/.bin.
    Test-linked locally with clang+lld: only newlib/libgcc symbols missing,
    .text ~35 KB of 64 KB.
    Claude-Session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
    [startup_stm32f103xb.c]
2026-11-01 fix(mode): non-blocking K/T/Z status reports
    mode_happiness/mode_stamina/mode_index blocked the main loop for up to
    10 s (Delay_s plus blocking shake/sleep moves), during which even the
    emergency stop was ignored. They now queue one combined GBK utterance via
    AudioTask and the follow-up pose via ActionTask. This also stops the
    blocking SYN_FrameInfo() and AudioTask from writing USART2 concurrently.
    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
    [Mode.c]
2026-11-01 fix(main): no command replay at zero stamina; non-blocking nanshou
    At stamina 0 the loop peeked USART RxData without consuming the flag and
    ran the blocking sleep routine; once stamina was restored the same byte
    was consumed again as a fresh command (sleep twice, +30 happiness).
    Bytes are now always consumed; at stamina <= 0 only '2'/'p' pass, and
    they go through ActionTask like everything else.
    mode_nanshou/mode_xiaodai no longer block (AudioTask + ActionTask).
    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
    [Mode.c, main.c]
2026-11-02 feat: independent watchdog; drop unreachable blocking dispatch
    - All motion bytes are owned by ActionTask, so the legacy if-chain of
    blocking mode_xxx() calls in main.c was dead code. Replace it with a
    small switch for the few non-motion commands (n/K/T/Z, mode switches).
    - New host test: every motion byte in docs/protocol.md is accepted by
    ActionTask and non-motion bytes are not (guards against silently
    falling back to blocking code).
    - Enable IWDG (~1.6 s, frozen while debugging; -DMANBO_NO_WATCHDOG to
    disable), fed once per loop. Safe now that the loop has no multi-second
    delays.
    Claude-Session: https://claude.ai/code/se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
    [Watchdog.h, main.c, test_state_machine.c]
2026-11-02 chore: convert all firmware sources to UTF-8 (byte-identical binaries)
    Sources mixed GBK, UTF-8 and both inside one file (main.c), so Keil and
    GitHub showed half of the comments as mojibake. tools/fix_encoding.py
    converts comments to UTF-8 and rewrites every non-ASCII string literal as
    \x escapes of its original bytes (GBK for SYN6288 speech and OLED font
    keys) plus a readable comment.
    Verified: every User/System/Hardware object file compiled before and
    after conversion is byte-identical (llvm-objdump -s). Three comments
    whose GBK bytes happened to be valid UTF-8 were fixed by hand.
    CI now rejects non-UTF-8 sources and raw non-ASCII literals.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
    [Mode.c, Mode.h, OLED.c, OLED.h, OLED_Data.c, OLED_Data.h, Timer.c, UltrasonicWave.c]
2026-11-02 feat(battery): 2S battery monitor for board V2 (PA4 / ADC1_IN4)
    - User/Battery.h: integer mV conversion for a 100k/33k divider, 8-sample
    moving average, LOW 6.8 V / CRITICAL 6.4 V with 200 mV hysteresis,
    "no battery" detection for USB-powered bench work. 13 host tests.
    - User/BatteryTask.c: non-blocking ADC sampling at 10 Hz from the sensor
    slot; compiles to a stub on the original wiring (always UNKNOWN).
    - main.c: LOW -> spoken charge reminder; CRITICAL -> stop walking, lie
    down, refuse motion (sleep and emergency stop still accepted).
    - Added to Project.uvprojx; Makefile picks it up automatically.
    Claude-Session: https://clau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
2026-11-02 refactor(mode): remove unreachable blocking mode_xxx functions
    21 legacy mode functions (mode_forward ... mode_xiaodai) had no callers
    left after ActionTask took over all motion commands. Also drop the
    ff/bb/ll/rr counters (replaced by PetStats gait_repeat) and rename the
    global `read` buffer (shadowed POSIX read()) to a static status_text.
    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
    [Mode.c, Mode.h, main.c]
2026-11-02 fix(sensor): ultrasonic ranging missed echoes shorter than 10 ms
    SensorTask runs every 10 ms but tried to catch Echo's rising and falling
    edges by polling. Any echo shorter than the poll interval (targets closer
    than ~170 cm, i.e. every obstacle that matters) was usually never seen,
    and the rest were under-measured because the start snapshot discarded
    ticks already counted by the TIM2 ISR.
    The ISR already accumulates 100 us ticks only while Echo is high, so
    ranging now waits one 30 ms window and reads that count directly.
    Echo still high at the deadline (no echo / out of range) or zero ticks
    (sensor missing) are reported invalid.
    New host test simulates the ISR at 0.1 ms resolution with 10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
    [SensorTask.c, test_sensor_task.c]
2026-11-02 refactor: delete dead Movement.c and legacy ultrasonic wrappers
    Hardware/Movement.c (blocking Delay_ms gaits) has no callers: every gait
    now lives as a PoseStep script in User/ActionTask.c. Removed from the
    repo and Project.uvprojx (history keeps it for reference).
    UltrasonicWave.c keeps only the GPIO init; Start/Getvalue/Bizhang
    wrappers were unused duplicates of SensorTask.
    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
2026-11-02 feat(servo): per-servo trim and soft end stops, integer math
    Hardware/ServoMath.h converts degrees to TIM3 pulse width with integer
    math and applies SERVO_TRIM_DEG (per-servo offset, to level a freshly
    assembled dog without re-seating horns) and SERVO_SAFE_MIN/MAX_DEG soft
    end stops (default 0..180 = unchanged gait behaviour). Pulse widths for
    the angles used by the gaits are identical to the old float code.
    15 host tests.
    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
2026-11-02 perf(oled): non-blocking image refresh, one page per 10 ms
    OLED_ShowImage() pushed the whole 1 KB frame over bit-banged I2C every
    time a face changed, stalling the loop (and the PoseStep timing) for the
    full transfer. It now only marks the touched pages dirty; AppTask_Ui
    (now every 10 ms) sends one 128-byte page per tick via OLED_UpdateStep().
    Explicit OLED_Update()/OLED_UpdateArea() calls are unchanged.
    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
    [AppTask.c, OLED.c, OLED.h]
2026-11-02 fix(boot): show face before greeting; quiet restart after watchdog reset
    With deferred OLED refresh the boot face only appeared after the 1 s
    greeting; push it synchronously at boot. After an IWDG reset skip the
    greeting so the dog recovers fast and does not bark in a reset loop.
    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
    [main.c]
2026-11-02 feat(hardware): carrier board V2 design data, KiCad schematic, BOM
    hardware/gen/design.py is the single source of truth (45 parts, 36 nets);
    build.py generates hardware/kicad/: KiCad 8 schematic (net label on every
    pin), symbol library, BOM, Blue Pill pin map and an SVG preview.
    Design highlights:
    - 2S input -> PTC 4 A -> Q2 AO4407A reverse-polarity protection -> Q1
    AO4407A high-side switch driven by a small panel switch (servo current
    never flows through the switch; a single FET cannot do both jobs
    because its body diode would leak when "off").
    - Separate buck modules for servo rail (>=3 A, 1000 uF bulk) and logic
    rail, so servo stalls no longer brown-out the MCU.
    - HC-SR04 Echo di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
    [bom.csv, manbo-carrier.kicad_sch]
2026-11-02 feat(hardware): footprints, board placement, unrouted PCB + preview
    - footprints.py: pad geometry (KiCad std-lib dimensions) plus custom
    Blue Pill socket and buck-module footprints, embedded in the board.
    - layout.py: 100 x 90 mm, 2-layer placement grouped by function
    (sensors on the front edge, Blue Pill with USB at the board edge,
    servo/module row, power section at the back).
    - kicad_pcb.py: KiCad 8 .kicad_pcb writer (nets, footprints with
    schematic paths, rounded outline, GND pour on both layers), placement
    checks (board edge, courtyard overlap, pad-to-pad clearance between
    nets) and an SVG preview with ratsnest.
    - .kicad_pro with net classes (battery/servo 1.5 mm, GND 1 mm).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
    [manbo-carrier.kicad_pcb]
2026-11-02 feat(hardware): auto-routed 2-layer board with independent DRC
    - router.py: 0.25 mm grid, 2 layers, 8-direction A* with vias; per-net
    width/clearance via obstacle dilation; multi-pin nets grow a tree;
    adjacent same-net SOIC pins are strapped first. Widest nets first.
    Copper is painted half a cell larger than drawn so grid rounding can
    never eat into the clearance.
    - drc.py: exact-geometry check (capsule tracks, rect/circle pads, vias):
    clearance per net class, edge clearance, per-net connectivity through
    vias and plated holes. Verified by fault injection (short, near miss,
    removed track).
    - Result: 36/36 nets routed incl. GND (1301 mm, 22 vias), 0 clearance
    violations, 0 unco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
    [manbo-carrier.kicad_pcb]
2026-11-02 feat(hardware): fab outputs - Gerber RS-274X + Excellon + upload zip
    gerber.py writes copper (with a solid GND pour on both layers made by
    clear-polarity knock-outs: 0.35 mm around other nets, 0.8 mm from the
    edge, 0.5 mm around mounting holes), solder mask (+0.05 mm, vias tented),
    paste, silkscreen (outlines, references, connector pin names via a small
    stroke font) and outline, plus PTH/NPTH drill files, zipped for upload
    to a PCB fab. No KiCad needed to order the board.
    Checked by re-parsing the Gerbers with an independent viewer.
    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
    [manbo-carrier-B_Cu.gbl, manbo-carrier-B_Mask.gbs, manbo-carrier-Edge_Cuts.gm1, manbo-carrier-F_Cu.gtl, manbo-carrier-F_Mask.gts, manbo-carrier-F_Paste.gtp, manbo-carrier-F_Silkscreen.gto, manbo-carrier-NPTH.drl]
2026-11-02 fix(hardware): 2920 PTC rated >= 16 V; hardware README; CI check
    - F1: 1812 PTCs don't reach 4 A hold and are often rated 6-8 V (< 8.4 V
    full 2S). Use a 3 A / >=16 V 2920 part (worst case ~2.4 A); re-placed
    the power cluster, still 0 DRC violations / 0 unconnected.
    - hardware/README.md: what V2 fixes, files, fab parameters, assembly
    order, step-by-step first power-up (set adjustable bucks to 5.0 V
    before anything is plugged in), V2 firmware flag, caveats.
    - CI regenerates the board and fails if committed outputs are stale.
    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
    [bom.csv, manbo-carrier.kicad_pcb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]
2026-11-02 fix(hardware): no mounting-hole reference silk outside the board
    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
    [manbo-carrier.kicad_pcb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]
2026-11-02 docs: rewrite README for the optimized project; flag outdated docs
    - README now matches the code: what changed, Keil/GCC build, V2 flag,
    wiring for original and V2 boards, quick command list, layout, tests.
    - Banners on early design docs that describe 8/12 servos or STM32F407,
    on PROJECT_SUMMARY.md, and on the review report (all items fixed).
    - ASRPro docs: command codes updated to the aligned protocol.
    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
2026-11-02 fix(comm): no lost commands; e-stop cancels continuous walking
    - main() read the single-byte "last received" UART variable, so a byte
    arriving before the loop got to it (an app sending 'x' then 'f') was
    overwritten. CommTask now forwards every byte from the UART rings into
    per-port command FIFOs (Bluetooth drained before voice, CR/LF dropped);
    main pops one command per loop. 5 new host tests.
    - SafetyTask_Run() cleared the stop request after aborting, so main()
    never saw it and resumed continuous walking right after an emergency
    stop. The request now stays set until main() consumes it (test updated:
    visible once, consumed exactly once).
    - Removed now-unused move_mode1/move_mode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
    [CommTask.c, CommTask.h, Mode.c, SafetyTask.c, main.c, test_comm_task.c, test_state_machine.c, usart1.h]
2026-11-02 fix(hardware): 3-char connector pin labels on silkscreen; plan update
    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
    [manbo-carrier-F_Silkscreen.gto]
2026-11-02 refactor(hardware): drop 7 redundant parts; router honours max clearance
    - Removed power LED D1/R11 (buck modules have one), extra 3V3 cap C7
    (Blue Pill has its own) and servo series resistors R1-R4. Kept the
    power switch / reverse protection and the echo divider.
    45 -> 38 parts, 7 -> 5 resistor values; re-routed: 31/31 nets,
    13 vias (was 22), 0 DRC violations.
    - Router: near power copper a signal track now keeps
    max(own, power) clearance, matching the DRC rule (previously passed
    only by luck; removing parts exposed it).
    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
    [bom.csv, manbo-carrier.kicad_pcb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]
2026-11-02 ci: validate schematic/PCB with real KiCad 8; GCC syscall stubs
    - New CI job installs KiCad 8 and runs kicad-cli ERC, DRC (with zone
    refill and schematic parity) and a Gerber/SVG plot as a cross-check
    of the generator's own checks. Reports are uploaded as artifacts.
    - gcc/syscalls.c: minimal newlib hooks so the GCC link no longer warns
    about nosys stubs (_write, _read, ...). Keil build unaffected.
    - actions/checkout v4 -> v5 (Node 20 deprecation).
    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
2026-11-02 ci: kicad-cli 8 has no --refill-zones (GND is fully routed anyway)
    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
2026-11-02 fix(hardware): clear courtyard overlaps found by KiCad 8 DRC
    First real KiCad 8 run: ERC 0 violations; DRC 0 clearance errors,
    0 unconnected, 0 schematic-parity issues, but 4 courtyard overlaps
    (Q2/Q1, Q1/C3, J15/H3, U1/C1). The generator's placement check compared
    bodies; it now compares courtyards (body + 0.25 mm) exactly like KiCad
    and reproduced the same 4 findings before the placement was adjusted.
    Also fixes a latent bug in drc.py: circle-vs-rect swapped the objects
    but not their kinds (that pair order had never occurred before).
    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
    [manbo-carrier.kicad_pcb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]
2026-11-02 docs: mark optimization complete; record KiCad 8 validation
    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
2026-11-02 docs(hardware): full purchase list; merge the two 100k resistors
    - hardware/采购清单.md: everything needed for one dog (PCB, on-board
    parts, Blue Pill, bucks, servos, modules, battery, charger, wiring),
    with search keywords and notes; linked from both READMEs.
    - R9 uses the same 100k 1% as R7, so the BOM has one fewer line.
    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
    [bom.csv, manbo-carrier.kicad_pcb, manbo-carrier.kicad_sch]
2026-11-02 feat(firmware): MANBO_LITE build - voice commands + motion only
    For the low-cost build (SU-03T voice module on USART3, servos, 4xAA):
    - No OLED, speech synthesis, ultrasonic/IR or stamina game: their init
    and loop code are compiled out; the on-board LED blinks per command.
    - Continuous gaits stop by themselves after MANBO_WALK_TIMEOUT_MS
    (10 s) in case the "stop" phrase is not recognised; 0 (off) in the
    full build.
    - make LITE=1; CI builds original / V2 / lite; the Cortex-M3 syntax
    check now runs all three variants. Lite image ~12 KB.
    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
2026-11-02 feat(hardware): LITE board - voice command + motion for ~40-65 CNY
    - design_lite.py / layout_lite.py: 70 x 54 mm, 12 parts. 4xAA box ->
    SS34 (reverse protection; trims fresh alkaline to ~6 V for SG90) ->
    servo rail + 1000 uF; M7 diode + 470 uF hold-up for Blue Pill and the
    SU-03T so servo dips cannot reset them. Routed 10/10 nets, 0 DRC.
    - Generator is now variant-aware (--variant lite) with the same router,
    DRC and Gerber code; full board routing unchanged.
    - docs/su03t.md: wiring and the phrase -> UART byte table to configure
    the SU-03T; hardware/lite/README.md and purchase list with rough
    prices; README shows both versions.
    - CI regenerates and KiCad-checks both boards.
    Co-Au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
    [bom.csv, manbo-carrier.kicad_pcb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]
2026-11-02 docs: lead with the LITE build; credit the maintainer
    - README hero shows the LITE board and the low-cost voice + motion
    build; maintainer line and license credit for @1708018656-ship-it.
    - LICENSE: add the maintainer's copyright line for the modifications
    (original notice kept, as MIT requires).
    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
2026-11-02 feat(lite): OLED faces and voice replies in the LITE build
    - MANBO_LITE now keeps the OLED (faces per command, boot face).
    - New Voice module: firmware-triggered replies. Full build speaks via
    SYN6288; LITE sends a 5-byte frame AA 55 <id> 55 AA to the SU-03T on
    USART3, which plays the phrase configured for it (boot greeting,
    "tired, stopping" on the walk timeout, generic OK). The SU-03T still
    answers recognised phrases by itself.
    - USART3 gets a non-blocking TX ring (TXE interrupt).
    - Stamina-only commands (n/K/T/Z) are gated on MANBO_HAS_PET_STATS.
    - Host test for the frame layout. LITE image ~16.7 KB.
    Claude-Session: https://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
2026-11-02 feat(lite): OLED header on the LITE board; docs for voice replies
    - LITE board: J7 for the 0.96in I2C OLED (PB8/PB9, 3V3 from the Blue
    Pill); re-routed 13/13 nets, 5 vias, 0 DRC.
    - docs/su03t.md: the three firmware-triggered phrases (AA 55 id 55 AA)
    to configure on the SU-03T platform.
    - LITE README / purchase list / main README: faces + voice replies,
    updated rough cost (about 50-75 CNY).
    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
    [bom.csv, manbo-lite.kicad_pcb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]
2026-11-02 fix(usart3): add the missing TX functions; strict local link check
    The previous commit only added the TXE branch of the ISR; the
    USART3_SendBytes/USART3_TxFree definitions were lost to a line-ending
    mismatch in the edit, so the LITE link failed in CI (the local check
    ignored undefined symbols and missed it).
    tools/link_check.sh now fails on any undefined symbol that newlib or
    libgcc would not provide, for all three variants.
    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
    [usart3.c]
2026-11-03 fix(hardware): vias 0.5/1.0 mm and 10 mil tracks for JLCEDA defaults
    Importing manbo-carrier.kicad_pcb into JLCEDA reported 13 "via size"
    errors: 0.4 mm holes vs its default minimum of 0.5 mm (19.7 mil).
    - Vias are now 0.5 mm hole / 1.0 mm pad on both boards.
    - Signal tracks 0.25 -> 0.254 mm (10 mil) and silkscreen pin-label
    strokes 0.12 -> 0.15 mm, also inside the usual JLC defaults.
    - drc.py no longer has the old via radius baked in; build.py passes the
    board's real via size, and .kicad_pro uses the same values.
    Both boards re-routed: 0 unrouted, 0 clearance violations.
    Claude-Session: https://claude.ai/code/session_011zCL3ZwaaXu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
    [manbo-carrier.kicad_pcb, manbo-lite.kicad_pcb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]
